dbraun1991/Caddy-Camper-Construction/Einkaufsliste.md

# Einkaufsliste & Budget — VW Caddy Mk3 Camper Ausbau

Preisstand: **Oktober 2026**, Richtpreise aus deutschen Online-Shops (Brutto, inkl. 19 % MwSt., ohne Versand).
Teilenummern beziehen sich auf [List_of_Materials.md](./List_of_Materials.md).

> ⚠ **Vor dem Zuschnitt der Sitz-/Tischbretter C1–C3:** [ADR 0013](docs/adrs/0013-rail-carrier-cheeks-for-seat-and-table-boards.md) ist noch offen (Schienenhöhe 76 mm vs. 32 mm Brettstärke). **Nach Lieferung der Schienen:** Arretierung und Stärke prüfen (Details in [List_of_Materials.md](./List_of_Materials.md) §E). Alles andere ist kaufbereit.

---

## 1 — Holz (Birke-Multiplex)

| Pos | Artikel | Menge | Einzelpreis | Summe |
|---|---|---|---|---|
| — | Multiplex Birke 18 mm, 2.500 × 1.250 mm | 3 Platten | 105 – 147 € | **315 – 441 €** |
| — | Multiplex Birke 12 mm, 2.500 × 1.250 mm | 1 Platte | 50 – 105 € | **50 – 105 €** |
| V16 | Ausgleichsleisten 10 × 40 mm unter dem Klappbrett Rücksitz (F1) | 2 m | ~2,5 €/m ¹ | **~5 €** |
| | | | **Teilsumme** | **~370 – 551 €** |

Spanne erklärt sich über die Qualitätsklasse (BB/BB vs. S/BB) und den Händler: Baumarkt (toom, Hornbach) am unteren Ende, Holzfachhandel (Holzland, Holzzentrum) am oberen.

**Zuschnitt:** 8 – 25 € je nach Händler. Lohnt sich hier klar — die großen Teile (T1, F1, F2, B1 je 1.120 mm breit) sind ohne Formatkreissäge kaum exakt zu schneiden, und ADR 0007 setzt maßhaltige Stirnkanten voraus. **Budget: ~20 €.** Erste Bestellung: 9 Teile in 18 mm, Maße in [List_of_Materials.md §Korpus](./List_of_Materials.md#korpus--unterbau-900-mm-tief-320-mm-hoch-1120-mm-breit) (Wände 340 mm hoch, [ADR 0020](docs/adrs/0020-through-tenons-instead-of-routed-grooves.md)). Passt rechnerisch auf 2 Platten; die 3. Platte und die 12-mm-Platte erst für Schubladen und Sitzbretter.

### Option: CNC-Fräsen statt Zuschnitt

Statt Zuschnitt + Stich-/Kreissäge können die 9 Bretter der ersten Bestellung fertig gefräst werden — mit Zapfen, Schlitzen und Aussparungen. Die Dateien liegen bereit: [`docs/cnc/gezapft/`](docs/cnc/gezapft/) (DXF je Brett + [`AUFTRAG.md`](docs/cnc/gezapft/AUFTRAG.md) zum Mitschicken, im Viewer Reiter „DXF · CNC“, [ADR 0023](docs/adrs/0023-cnc-dxf-export-with-dogbones.md)). **Preis: auf Anfrage**, noch kein Angebot. Fräserdurchmesser (angenommen 6 mm) und Passungsluft (0,2 mm) erst nach Rückmeldung des Anbieters in `modell/parameter.json` → `cnc` festlegen und neu erzeugen.

**Zweiter Auftrag: Schubladenkästen D1–D3** ([`docs/cnc/schubladen/`](docs/cnc/schubladen/), [ADR 0024](docs/adrs/0024-cnc-drawer-boxes-finger-joints-and-lightening-windows.md)): 12 Wände in 18 mm mit Fingerzinken und Fenstern (D1/D2) bzw. Lochraster (D3), 3 Böden in 12 mm mit Zapfen — Material dafür ist die 3. Platte 18 mm und die 12-mm-Platte aus der Tabelle oben. Preis ebenfalls auf Anfrage. Die Schienenstärke (bestimmt die Kastenbreite) ist gemessen: 19 mm wie geplant (2026-11-12). Vor der Bestellung nur noch die Schraublöcher der Schiene gegen das volle Schienenband prüfen. Schrauben V8 und Eckleisten V12 entfallen dadurch, ohne Frontblenden auch die Griffe V6 ([ADR 0027](docs/adrs/0027-no-drawer-front-panels-box-front-with-grip-cut-out.md)).

Anbietersuche (**Recherche 2026-11-07**, nur Webseiten gelesen, niemand angefragt). Ziel: Abholung selbst, Raum Duisburg.

| Anbieter | Ort | Stand laut Webseite | Offen |
|---|---|---|---|
| [Brockmann Holz](https://brockmann-holz.de/timber-processing.html) | Bataverstraße 1, 47809 Krefeld · 02151 5124-0 · info@brockmann-holz.de | CNC-Bearbeitungszentrum (Fräsen von Konturen); Birke-Multiplex BFU 100, 4–50 mm, 1.250 × 2.500 mm | Privatkunden? Abholung? Dateiformat? — **erster Kandidat** |
| [RheinRuhr-Holz](https://rheinruhr-holz.de/) | Zinkstr. 30, 45356 Essen | Privatkunden ja, Abholung kostenlos; Zuschnitt nur für Balken (KVH) | kein CNC-Fräsen genannt — höchstens Material |
| [HRW FabLab](https://fablabs.io/labs/hrwfablab?locale=es) | Bottrop | „CNC milling“ gelistet | ob eine Portalfräse für ganze Platten da ist; selbst fräsen |
| Verzeichnis [wlw.de, Duisburg](https://www.wlw.de/de/suche/cnc-fraesarbeiten-fuer-holz/duisburg) | Duisburg / Moers | Einträge u. a. A-Z Möbelfertigteile Tischlerservice, hasenkamp Service (Moers) | alles ungeprüft |
| [Panelzz](https://www.panelzz.com/de/service/maatwerk/) | Wijlre (NL), Versand | fräst Multiplex nach DXF 1:1, Nesting | keine Birke im Sortiment |
| [Hobeth / Holz-Zentrum Theile](https://hobeth.de/holz-cnc-fraesen-lassen/) | Elsterwerda (Brandenburg), Versand | DXF/STEP, auch privat | weit weg |
| [Plattenzuschnitt24](https://www.plattenzuschnitt24.de/Multiplexplatten-Zuschnitt/Multiplexplatte-Birke/) | online, Versand | Birke-Multiplex „gesägt oder gefräst“ | ob Konturen nach DXF |

Nur Plattenzuschnitt (gerade Schnitte, für Zapfen/Schlitze nicht ausreichend, aber z. B. für die reinen Rechtecke F1/F2 oder die Variante „stumpf“):

| Anbieter | Ort | Stand laut Webseite (2026-11-07) | Offen |
|---|---|---|---|
| [myspiegel.de](https://www.myspiegel.de/multiplex-birke-pb-1193.html) | Holländische Str. 207b, 34127 Kassel · **versendet** | Zuschnitt-Konfigurator für Rechtecke (max. 122 × 247 cm, Mindestfläche 0,3 m²); Lieferung mit eigenen Fahrzeugen, in Deutschland 9,90 €, ca. 5–8 Arbeitstage; Abholung im Werk Kassel möglich. Birke-Multiplex in sechs Stärken von 4 bis 21 mm; Äste ausgebessert und „deutlich zu erkennen“, laut Shop **„zum Möbelbau nicht geeignet“** | ob 18 mm lieferbar ist (Stärken nicht einzeln genannt); kein Fräsen nach DXF genannt |
| [AuProTec](https://auprotec.de/de/zuschnitt/multiplex-platten/c/000484) | online | „Zuschnitt nach Maß“, Birke-Multiplex 6,5–30 mm | Produktseite ließ sich nicht auslesen — Fräsen, Versand und Standort nicht geprüft |

Holz Leineweber in Duisburg hat 2019 geschlossen. Daneben lohnt die direkte Frage bei Tischlereien in Duisburg/Moers — viele haben eine CNC-Nesting-Anlage, ohne es online anzubieten.

---

## 2 — Vollauszug-Schienen (der größte Einzelposten)

| Pos | Artikel | Menge | Einzelpreis/Paar | Summe |
|---|---|---|---|---|
| E1 | Schwerlastschiene AOLISHENG 850 mm · 170 kg · 76 mm hoch · Arretierung — Sitzbretter links/rechts (C1/C2) + Tischbrett Mitte (C3) | 3 Paare | 104,99 € | **~315 €** |
| E2 | Schiene AOLISHENG 850 mm · 80 kg · 53 mm hoch · Arretierung — Schubladen (D1–D3) | 3 Paare | 61,99 € | **~186 €** |
| | | | **Teilsumme** | **~501 €** |

Gut **ein Drittel des Gesamtbudgets**. Beide aus derselben 850-mm-Serie ([ADR 0017](docs/adrs/0017-850-mm-runners-in-900-mm-corpus.md)); Schwerlast überall, wo eine Person sitzen kann — auch auf dem Tischbrett C3 ([ADR 0021](docs/adrs/0021-table-board-on-170-kg-runners.md)). Bestellt sind 2 × E1 + 4 × E2 (2026-11-04): Stand 2026-11-12 laut Bauherr: **3 Paare E1 + 3 Paare E2**, passend bestellt. 170-kg-Schiene: Einbaumaß laut Hersteller 19,2 + 0,5 mm je Seite, passt. Geliefert, gemessen 2026-11-12: beide Typen **19 mm** stark wie geplant, Höhen 53 / 76 mm, Längen 850 / **870 mm** (+ Arretierungshebel vorn), 170-kg-Schiene für **M6**-Schrauben ([ADR 0028](docs/adrs/0028-height-plan-board-on-cheeks-foolproof-runner-layout.md)).

- Bei den Sitz- und Tischbrettern **nicht** sparen: dort sitzt eine Person bei 850 mm Auszug, und ADR 0008 macht die Arretierung zur harten Anforderung.
- Preisvergleich: Nicht-Amazon-Quellen (teleskopschienen-shop.de, teleskopschienen24.de) lagen bei 900 mm/120 kg um ~84 €/Paar — 850 mm dort prüfen.

---

## 3 — Befestigungsmaterial

| Pos | Artikel | Menge | Summe |
|---|---|---|---|
| V1 | Schrauben Torx Senkkopf 4 × 45 mm | ~80 Stk. (1 Pack 100) | ~12 € |
| V2 | Schrauben Torx 3,5 × 16 mm, Flach-/Tellerkopf (80-kg-Schienen) | ~70 Stk. (1 Pack 100) | ~8 € |
| V18 | Schrauben Torx 5 × 16 mm, Flach-/Tellerkopf (170-kg-Schienen, M6-Löcher) | ~60 Stk. (1 Pack 100) | ~10 € ² |
| V3 | Stahlwinkel 40 × 40 × 2 mm | 12 Stk. | ~18 € |
| V4 | Holzdübel Ø 8 × 40 mm | ~30 Stk. (1 Pack 50) | ~6 € |
| V5 | Holzleim D3 wasserfest, 750 ml | 1 Flasche | ~12 € |
| V7 | Schrauben 4 × 30 / 4 × 40 mm | je 1 Pack 100 | ~20 € |
| V9 | M6 × 30 Durchsteckschrauben + U-Scheibe + Stoppmutter | 24 Sätze | ~15 € ² |
| V10 | M8 × 30/40 + U-Scheibe + Stoppmutter | 4 Sätze | ~6 € |
| V11 | Spanngurt mit Ratsche | 2 Stk. | ~20 € |
| V15 | Gurtschlaufe verstellbar (Gurtband ~25 mm + Klemmschnalle), Klappbrett Kopfende (F2) ↔ Kopfstütze | 2 Stk. | ~10 € ¹ |
| V17 | Klappscharniere Standard ~60 mm (3 × Deckplatte ↔ Klappbrett Rücksitz oben, 3 × zwischen den Klappbrettern unten) | 6 Stk. | ~15 € ¹ |
| | | **Teilsumme** | **~154 €** |

¹ V15/V16/V17 am 2026-10-17 ergänzt — grobe Schätzung, Quellen noch nicht geprüft.  
² V9 (M6 statt M5) und V18 am 2026-11-12 nach dem Datenblatt der 170-kg-Schiene geändert bzw. ergänzt ([ADR 0028](docs/adrs/0028-height-plan-board-on-cheeks-foolproof-runner-layout.md)) — grobe Schätzung.

---

## 4 — Ausbau / Sonstiges

| Pos | Artikel | Menge | Summe |
|---|---|---|---|
| G1 | Matratze — **Variante A:** Standard 100 × 200 × 8–13 cm Kaltschaum | 1 | 60 – 150 € |
| G1 | Matratze — **Variante B:** Maßanfertigung 110 × 200 × 8 cm | 1 | 230 – 550 € |
| G2 | Matratzenbezug, atmungsaktiv | 1 | 30 – 60 € |
| G3 | Antirutschmatte / Gummimatte 1.120 × 900 mm | 1 | 15 – 30 € |
| G4 | Kantenband Buche 18 mm selbstklebend | ~8 m | ~10 € |
| G5 | Holzöl / Hartwachsöl | 0,75 l | 20 – 30 € |
| | | **Teilsumme (Variante A)** | **~135 – 280 €** |
| | | **Teilsumme (Variante B)** | **~305 – 680 €** |

**Zur Matratze:** die geplanten **1.100 mm** sind kein Handelsmaß — Standardgrößen sind 900 oder 1.000 mm. Drei Wege:

1. **100 × 200 cm von der Stange** (60 – 150 €) und 100 mm Luft in Kauf nehmen oder mit einem Schaumstreifen füllen. Günstigste Lösung.
2. **Schaumplatte RG40, 2.000 × 1.100 × 80 mm zuschneiden lassen** (~100 – 160 €) und separat beziehen. Bestes Preis-Leistungs-Verhältnis beim geplanten Maß.
3. **Wohnmobil-Matratze nach Maß** (230 – 550 €, Vanmade/Frankenschaum/matratzenachmass). Komfortabel, aber hier der teuerste Posten pro Nutzen.

---

## 5 — Gesamtbudget

| Block | Günstig | Mittel (realistisch) | Komfort |
|---|---|---|---|
| Holz + Zuschnitt | 390 € | 467 € | 571 € |
| Schienen | 501 € | 501 € | 501 € |
| Befestigungsmaterial | 154 € | 154 € | 154 € |
| Ausbau / Sonstiges | 135 € | 230 € | 680 € |
| **Summe** | **~1.180 €** | **~1.350 €** | **~1.905 €** |
| + Puffer 10 % (Verschnitt, Nachkauf, Versand) | ~120 € | ~135 € | ~190 € |
| **Gesamt** | **~1.300 €** | **~1.485 €** | **~2.095 €** |

### Realistische Planungsgröße: **~1.500 €**

Das setzt voraus: Multiplex aus dem Baumarkt mit Zuschnitt, die empfohlenen Schienen, Matratze als zugeschnittene Schaumplatte, Werkzeug schon vorhanden.

**Nicht enthalten:** Werkzeug (Akkuschrauber, Handkreissäge mit Führungsschiene und Stichsäge für die Zapfen, Feilen — oder Dübelhilfe bei stumpfer Variante, Senker), Versandkosten, sowie die noch offenen Punkte Belüftung und 12-V-Installation aus der [README](./README.md#weiterführende-planung).

---

## 6 — Einordnung

Die kommerzielle Alternative [Moonbox 111](https://www.moonbox.de/products/moonbox-111) liegt je nach Ausstattung bei grob 900 – 1.400 € — allerdings ohne Vollauszüge in dieser Tragfähigkeit und ohne drei unabhängige Sektionen. Der Eigenbau rechnet sich hier nicht über den Preis, sondern über die Vollauszug-Funktion und die Passgenauigkeit; die 6 Schwerlastschienen allein kosten mehr als ein Drittel einer Moonbox.

---

## 7 — Kaufreihenfolge

Die Montagereihenfolge in [§H](./List_of_Materials.md#montagereihenfolge) gibt die Kaufreihenfolge vor — der fertige Korpus liefert das verbindliche Innenmaß, nicht die Zeichnung:

1. **Jetzt:** Holz 18 mm + 12 mm mit Zuschnitt (oder die 18-mm-Teile CNC-gefräst, §1), Leim, Dübel, Schrauben V1/V2/V7, Winkel V3, Spanngurte V11 → Korpus bauen
2. **Schienen** E1 (3 Paare) + E2 (3 Paare), Durchsteckschrauben V9 → Arretierung und Stärke prüfen, einmessen und montieren (Bretter C1–C3 erst nach ADR 0013 zuschneiden)
3. **Nach Einbau im Fahrzeug:** M8-Sätze V10 (Gewinde der Zurrösen erst am Auto prüfen; Rücksitz-Ösen liegen neben dem Korpus → Winkel außen an S1/S2, ADR 0016)
4. **Zuletzt:** Matratze G1 + Bezug G2 — erst messen, wenn die Liegefläche real liegt; Scharniere V17, Gurtschlaufen V15 und Ausgleich V16 beim Anpassen von F1/F2 im Fahrzeug
