dbraun1991/Caddy-Camper-Construction/Hinweise-Sommernutzung.md

# Hinweise zur Sommernutzung — Schlafen im Fahrzeug

Dieses Dokument sammelt Punkte rund ums Schlafen im Auto, die **über die Konstruktion
des Ausbaus hinausgehen** — Themen, die unabhängig vom konkreten Innenausbau gelten,
aber jeder Nutzung eines Fahrzeugs als Schlafplatz anhaften.

**Rahmenbedingungen dieser Einschätzung** (bewusst explizit gemacht, weil sie entscheiden,
was hier wichtig ist und was nicht):

- **Nur Sommer-/Übergangszeit.** Deshalb werden Standheizung und **Kondensat**
  (Feuchtigkeit schlägt sich an kalten Scheiben/Wänden nieder, Schimmelrisiko über Wochen)
  hier **bewusst nicht behandelt** — das sind primär Kälte-/Dauerbetrieb-Probleme. Bei
  Nutzung außerhalb des Sommers (Übergangszeit, erste/letzte Törns) sollte das nachgezogen
  werden. **Davon zu unterscheiden** ist der CO₂-/Frischluftbedarf durch die Atmung selbst
  (→ Abschnitt 3) — der ist nicht saisonabhängig und bleibt deshalb vollständig in Scope,
  auch im Sommer.
- **Der Caddy ist aktuell ein normales Serienfahrzeug.** Keine Scheibentönung, keine
  Vorhänge, keine Dachluke, keine Mückengitter, keine Standheizung, keine Umbauten an
  Sitzen/Gurten/Kopfstützen außer dem hier geplanten Ausbau. Alles unten ist also etwas,
  das fehlt, nicht etwas, das schon vorhanden ist und nur geprüft werden muss.

---

## 1 — Rechtliches: Rasten ist erlaubt, Campen oft nicht

In Deutschland ist das Schlafen im Fahrzeug zur eigenen Erholung (Sekundenschlaf-Vermeidung,
Fahrtunterbrechung) grundsätzlich erlaubt und sogar erwünscht — auch auf Autobahnrastplätzen,
zeitlich im Rahmen einer "angemessenen Ruhezeit" (häufig genannte Richtgröße: bis zu einer
Nacht). **Camping** — Tisch und Stühle vor dem Fahrzeug aufstellen, Markise ausfahren,
sich sichtbar häuslich einrichten — ist dagegen auf Rastplätzen, in vielen Innenstädten und
in Naturschutzgebieten verboten und wird von Gerichten und Kommunen unterschiedlich streng
ausgelegt. Die Grenze zwischen beidem ist nicht gesetzlich scharf definiert, sondern
Einzelfallrechtsprechung — "wirkt es wie ein Zeltplatz" ist das informelle Kriterium.

⚠ **Das betrifft diesen Ausbau konkret:** Der **Bankmodus** fährt Sitz- und Tischbrett
850 mm nach hinten aus der offenen Heckklappe heraus — das ist im Erscheinungsbild genau
die Camping-Geste (Tisch + Sitzgelegenheit außerhalb des Fahrzeugs), die diese Abgrenzung
adressiert, auch wenn technisch alles am Fahrzeug montiert bleibt.

**Praktische Konsequenz:**

| Modus | Rechtlich unauffällig | Nur an erlaubten Stellplätzen |
|---|---|---|
| Schlafmodus | ✅ überall, wo Parken/Rasten erlaubt ist | — |
| Packmodus (Schubladen raus, kein Sitzmöbel sichtbar) | ✅ meist unkritisch | — |
| **Bankmodus** (Tisch/Sitzbrett sichtbar ausgefahren) | ⚠ nein | Nur auf ausgewiesenen Reisemobil-Stellplätzen oder mit Erlaubnis |

→ Bankmodus als "das ist jetzt ein Zeltplatz"-Signal einplanen, nicht als generell nutzbare
Funktion. Auf Autohof/Rastplatz lieber im Schlafmodus bleiben und nur innen sitzen.

---

## 2 — Zulassung / StVZO: Serienfahrzeug bleibt verkehrssicher

Der Ausbau darf die Zulassung des Fahrzeugs als PKW/Kombi nicht gefährden. Drei konkrete
Punkte, die über die reine Konstruktion hinausgehen:

- **Sichtfeld:** Sichtschutz/Verdunkelung (→ Abschnitt 4) darf **nur im Stand** angebracht
  sein, nie während der Fahrt — auch nicht an Seiten- oder Heckscheiben, falls diese für
  Schulterblick/Rückspiegel relevant sind.
- **Fahren mit geklappter Liegefläche (Fahrmodus 1/2):** Die auf die Box geklappten
  Klappbretter (F1, F2) hängen nur an den Scharnieren — vor der Fahrt mit einem Spanngurt am Korpus sichern,
  Matratze gesichert verstauen. Lose Platten dieser Größe werden bei einer Vollbremsung zu
  Geschossen.
- **Kopfstützenfunktion beim Klappbrett Kopfende (F2):** Das Klappbrett Kopfende wird laut `List_of_Materials.md` §H4 mit
  zwei verstellbaren Gurtschlaufen an den Vordersitz-Kopfstützen fixiert; die Zuglast tragen
  die Kopfstützen. Die Kopfstützen müssen dafür in Normalposition
  bleiben und ihre HWS-Schutzfunktion (Kopfstütze fängt den Kopf bei Auffahrunfall) behalten
  — die Befestigung darf sie nicht nach vorne ziehen, blockieren oder in der Höhe
  verstellen. Vor der ersten Fahrt mit montiertem F2 die Kopfstützen auf normale Beweglichkeit
  prüfen.
- **Zuladung (Zuladung/Nutzlast) — noch nicht geprüft:** Der gesamte Ausbau wiegt grob
  geschätzt:

  | Posten | Gewicht |
  |---|---|
  | Multiplex 18 mm (~7,5 m² × 18 mm × ~700 kg/m³) | ~95 kg |
  | Multiplex 12 mm (~1,5 m² × 12 mm × ~700 kg/m³) | ~13 kg |
  | 6 Schienenpaare (12 Stk.) | ~12 kg |
  | Kleineisen (Schrauben, Winkel, Dübel, Leim) | ~5 kg |
  | Matratze | ~10 kg |
  | **Ausbau gesamt (Leergewicht)** | **~135 kg** |

  Dazu kommen Insassen (2 Personen ≈ 150 kg) und Gepäck/Campingausrüstung (~30–50 kg) —
  grob **315–335 kg zusätzlich zum Serienzustand**. Die Nutzlast eines Caddy Mk3 Kombi
  schwankt stark nach Motorisierung/Ausstattung (Erfahrungswerte reichen von ~425 kg bis
  ~770 kg). **Vor dem Bau im Zulassungsschein/Zulassungsbescheinigung Teil I prüfen:**
  Feld F.1 (zul. Gesamtmasse) minus Leergewicht = tatsächliche Nutzlast dieses konkreten
  Fahrzeugs. Bei einer knapp bemessenen Nutzlast ist der 18-mm-Multiplex-Anteil der größte
  Hebel, falls Gewicht gespart werden muss.

- **Ladungssicherung während der Fahrt:** bereits entschieden, siehe
  [ADR 0012](docs/adrs/0012-non-destructive-vehicle-tie-down.md).

---

## 3 — Lüftung: Hitze und CO₂ sind die Probleme, nicht Feuchtigkeit

Zwei getrennte, beide saisonunabhängige Gründe, warum ein komplett geschlossenes Fahrzeug
über Nacht keine gute Idee ist — Kondensat (Abschnitt-übergreifend bewusst ausgeklammert,
siehe oben) ist keiner davon:

**a) CO₂-Anstieg durch Atmung.** Zwei schlafende Erwachsene atmen zusammen grob 25–30 l
CO₂ pro Stunde aus. Bei einer Kabinenluftmenge von überschlägig ~3 m³ (3.000 l) und
**keinem** Luftaustausch wäre die CO₂-Konzentration nach 8 Stunden rein rechnerisch im
Bereich mehrerer Zehntausend ppm — weit über der Schwelle (ca. 2.000–5.000 ppm), ab der
Kopfschmerzen, Benommenheit und schlechter, unruhiger Schlaf auftreten. In der Praxis ist
kein Fahrzeug hundertprozentig luftdicht (Türdichtungen, Kabeldurchführungen, Ablauflöcher
lassen immer etwas durch), ein echtes Erstickungsrisiko bei diesem Luftvolumen ist deshalb
unwahrscheinlich — aber sich auf die Restundichtigkeit zu verlassen ist kein Sicherheitskonzept,
und "schlecht geschlafen, Kopfschmerzen am Morgen" ist ein beim Autoschlafen häufig
berichtetes, vermeidbares Problem.

**b) Hitzestau.** Ein geschlossenes Fahrzeug in der Sommersonne heizt sich tagsüber stark
auf; nachts kühlt es ohne Luftaustausch langsamer ab.

Beide Probleme teilen dieselbe Lösung — Fenster angekippt lassen — aber aus zwei
unabhängigen Gründen, nicht nur wegen der Hitze:

- **Zwei gegenüberliegende Fenster ankippen, nicht nur eines** — Querlüftung sorgt auch
  ohne Wind für echten Luftaustausch statt stehender Luft in einer Ecke.
- Dafür braucht es **Einbruchschutz am offenen Spalt** (siehe Abschnitt 6) und einen
  **Insektenschutz** (Abschnitt 5), sonst ist die Lüftung nachts nicht praktikabel.
- Tagsüber beim Parken in der Sonne: Frontscheiben-Sonnenschutz von außen reduziert den
  Hitzestau deutlich mehr als jede Lüftungsmaßnahme im Innenraum.
- Die bereits geplante offene Vorderseite des Korpus (`README.md` "Render-Architektur")
  und der nicht abgedichtete Laderaum helfen hier zufällig mit — es gibt ohnehin keinen
  luftdichten Kasten, der zusätzlich belüftet werden müsste.
- **Objektive Kontrolle statt Bauchgefühl:** ein einfaches batteriebetriebenes CO₂-Messgerät
  (ab ~30–50 €) zeigt, ob der gewählte Fensterspalt tatsächlich reicht — deutlich
  verlässlicher, als am Morgen an Kopfschmerzen zu merken, dass er es nicht tat.

---

## 4 — Sichtschutz & Sonnenschutz

Serienfahrzeug ohne Tönung heißt: von außen ist nachts alles einsehbar, tagsüber heizt sich
der Innenraum ungebremst auf. Zwei Funktionen, ein Produkt:

- **Thermo-/Verdunkelungsmatten** (zugeschnitten auf die Scheibenformen, z. B. Saugnapf-
  oder Klemmbefestigung) für Front-, Seiten- und Heckscheiben — wirken gegen Einblick von
  außen **und** gegen Aufheizen tagsüber.
- Nur im Stand anbringen (siehe Abschnitt 2, Sichtfeld).
- Kostengünstige Variante: reflektierende Isoliermatten (Pkw-Zuschnitt, pro Scheibe
  einzeln) statt eines kompletten Sets — für einen Serienwagen ohne Sonderzuschnitt meist
  ausreichend.

---

## 5 — Insektenschutz

Ohne Mückengitter ist "Fenster nachts offen" (Abschnitt 3) im Sommer kaum nutzbar.

- Magnet- oder Klett-Mückennetze für die vorderen Fenster (passend zum Fensterrahmen,
  Caddy-spezifisch oder Universal-Zuschnitt).
- Mückennetz für die Heckklappe, falls diese im Bankmodus zum Lüften/Sitzen offen bleibt —
  wird ebenfalls erst bei Umsetzung des Ausbaus relevant, da die Heckklappe dann häufiger
  offen steht als im Serienbetrieb.

---

## 6 — Einbruch-/Diebstahlschutz

Ein gekipptes Fenster zum Lüften (Abschnitt 3) ist ein Zielpunkt. Faustregeln:

- Fenster nur so weit öffnen, wie ein Arm nicht durchpasst, oder ein Fenstergitter/-spanner
  verwenden, der den Spalt zusätzlich sichert.
- Zentralverriegelung aktiv halten (bei VAG-Fahrzeugen über die Fernbedienung auch von
  außen fernsteuerbar — Komfortfunktion vorher prüfen, ob sie bei nur angelehnten Fenstern
  trotzdem korrekt verriegelt).
- Wertsachen grundsätzlich nicht sichtbar liegen lassen — bei einem erkennbaren
  Campingausbau (Schubladen, Brettkante sichtbar) ist das Fahrzeug als "da ist wahrscheinlich
  Ausrüstung drin" erkennbar, was es als Ziel eher interessanter macht als ein leerer
  Serien-Caddy.

---

## 7 — Stellplatzwahl

- Eben und ruhig — auf 320 mm Plattformhöhe ohne Niveauausgleich schläft es sich auf einer
  Steigung unangenehm, und die Schienen-Arretierungen (ADR 0008) sind für Lastaufnahme
  ausgelegt, nicht als Bremse gegen Wegrollen von Schubladen bei starker Seitenneigung.
- Nur an Stellen parken, an denen Übernachten erlaubt ist (siehe Abschnitt 1) — offizielle
  Stellplätze, Wanderparkplätze ohne Verbotsschild, oder mit Zustimmung (z. B. Hofplatz).
- Eher belebte/beleuchtete Orte statt komplett abgelegen — Sichtschutz (Abschnitt 4) macht
  den Einblick zwar schwerer, ersetzt aber keine sichere Umgebung.

---

## 8 — Brandschutz / CO (falls ein Kocher mitgeführt wird)

Noch nicht Teil der Materialliste, aber ein häufiger Begleiter bei dieser Art Ausbau — daher
als Warnhinweis hier, falls ein Gas- oder Benzinkocher angeschafft wird:

- **Nie im Innenraum kochen** — Kohlenmonoxid-Vergiftung ist lautlos und bei geschlossenem
  Fahrzeug im Schlaf tödlich. Kocher ausschließlich draußen bei offener Tür/Heckklappe mit
  Blick auf den Kocher verwenden, nie "schnell drin" bei Regen.
- Falls doch ein Kocher fest verbaut werden sollte (aktuell nicht geplant): das wäre ein
  eigener Punkt mit CO-Warnmelder und Gasflaschenkasten mit Bodenentlüftung, kein
  nachträglicher Zusatz.

---

## Zusammenfassung: was zu besorgen/prüfen ist

| # | Punkt | Typ |
|---|---|---|
| 1 | Zuladung im Zulassungsschein prüfen (Feld F.1 − Leergewicht) | Prüfung, keine Anschaffung |
| 2 | Kopfstützenfunktion mit montiertem F2 testen | Prüfung |
| 3 | Thermo-/Verdunkelungsmatten für Front-, Seiten-, Heckscheiben | Anschaffung |
| 4 | Mückennetze für vordere Fenster + Heckklappe | Anschaffung |
| 5 | Fenstersicherung für den gekippten Lüftungsspalt | Anschaffung |
| 6 | Bankmodus nur an erlaubten Stellplätzen nutzen | Verhaltensregel, keine Anschaffung |
| 7 | Immer 2 gegenüberliegende Fenster ankippen (CO₂ + Hitze, → Abschnitt 3) | Verhaltensregel, keine Anschaffung |
| 8 | Optional: CO₂-Messgerät zur Kontrolle des Fensterspalts | Anschaffung (optional) |

Diese Posten sind **nicht** in [Einkaufsliste.md](./Einkaufsliste.md) eingerechnet, da sie
nicht zum Korpus-/Ausbau-Budget gehören. Geschätzte Zusatzkosten für Punkte 3–5 und 8: grob
90–170 €.
