dbraun1991/Caddy-Camper-Construction/docs/adrs/0017-850-mm-runners-in-900-mm-corpus.md

# 0017: 850 mm runners in the 900 mm corpus

Status: Accepted — amends [ADR 0008](0008-heavy-duty-full-extension-runners.md) (runner length only); amended by [ADR 0021](0021-table-board-on-170-kg-runners.md) (`C3` moves to the 170 kg runner) — **amended by [ADR 0028](0028-height-plan-board-on-cheeks-foolproof-runner-layout.md)**: the delivered 170 kg runners measure 870 mm
(+ 30 mm lock lever in front), the 80 kg runners 850 mm; both still fit the 882 mm clear depth.

## Context

ADR 0008 chose 900 mm runners because the corpus is 900 mm deep. The overlap
check from ADR 0015 showed that this never fitted: the back wall `R1` (18 mm)
leaves **882 mm** of clear depth, so 900 mm runners, the 880 mm drawer boxes
behind their 18 mm fronts, and the 900 mm seat/table boards all ran 14–18 mm
into the back wall (18 overlaps).

The 900 mm corpus depth itself has a real reason: the lid `T1` is part of the
sleeping platform and must reach the folded rear seats where `F1` starts. The
measured load depth is 920–930 mm (2026-10-17). The builder wants to keep the
corpus at 900 mm and keep ~2 cm of air at the rear-seat end, not use the space
for a deeper corpus.

Options:

- **Corpus 918 mm** (back wall behind 900 mm clear depth) — keeps 900 mm runners,
  but only 2–12 mm left to the rear seats.
- **Thinner back wall** (12 mm) — 888 mm clear, still too short, and weakens the
  main anti-racking panel (ADR 0007).
- **850 mm runners in the unchanged corpus** — chosen.

## Decision

- Corpus stays **900 mm** deep; 20–30 mm air to the rear seats.
- Two runners from the same AOLISHENG 850 mm full-extension series, both with
  lock (prices seen 2026-10-17):
  - **Seat boards `C1`/`C2`** (a person sits on them): 170 kg, 76 mm high,
    104.99 € per pair — 2 pairs.
  - **Drawers `D1`–`D3` and table board `C3`**: 80 kg, 53 mm high, 61.99 € per
    pair — 4 pairs. Luggage and a table, not a seat.
  - The 95 kg / 53 mm board runner from ADR 0008 is dropped (only found in
    900 mm).
- The assignment lives in `modell/parameter.json` (`schienen.typen`,
  `schienen.zuordnung`); rail bands are derived per type (seat L/R 18–94,
  drawer L/R ≈ 202–255, drawer M ≈ 78–131, table M 262–315 mm — no overlap on
  the dividers).
- Derived in `modell/parameter.json`: drawer box depth **830 mm** (runner − 20,
  as before), seat/table board depth **850 mm** (= runner length).
- Behind the runners and elements: **32 mm** clear space before `R1`.

## Consequences

- The 18 back-wall overlaps are gone; what remains are the open corner
  construction and the drawer-front/runner conflict.
- Extension in Bankmodus/Packmodus is 850 mm instead of 900 mm. The tipping
  estimate in ADR 0016 (based on 900 mm) stays as a slightly conservative figure.
- **To verify before ordering:** the runner thickness per side. The listing
  gives the 76 mm height but not the thickness; every element width is computed
  with 19 mm (ADR 0006/0008), for both types. A different thickness changes the
  affected element widths and must go into `schienen.typen.<typ>.staerke`.
- The lock requirement of ADR 0008 is unchanged. ADR 0008's note that the 95 kg
  board runners are the limit of the seating arrangement no longer applies —
  the seat boards now run on 170 kg runners. The table board's 80 kg runner is
  not meant to be sat on.
- The seat boards now face a **76 mm** runner instead of 53 mm (the table board
  stays at 53 mm), which changes the numbers in the still-open ADR 0013.
