dbraun1991/Caddy-Camper-Construction/docs/adrs/0018-continuous-bottom-and-lid-walls-in-grooves.md

# 0018: Continuous bottom and lid; walls housed in grooves between them

Status: Accepted, grooves replaced by through tenons in [ADR 0020](0020-through-tenons-instead-of-routed-grooves.md); continuous `B1`/`T1` still applies. Amends [ADR 0007](0007-dowel-screw-bracket-joinery.md).

## Context

The cut list gave the walls `S1/S2`/`M1/M2` 320 mm height *and* the bottom `B1` and back
wall `R1` the full 1,120 mm width. That only works if somebody decides which
panel runs through at each corner; the overlap check (ADR 0015) showed them
colliding at every corner. The workshop drawings offered three variants.

The builder's decision (2026-10-17): **bottom plate `B1` and lid `T1` run through
at the full 1,120 × 900 mm**; all walls stand between them. On top of that the
builder intends to rout recesses into `B1` and `T1` so the walls plug in —
which turns the overlap into an intended housing joint.

## Decision

- `B1` and `T1`: 1,120 × 900 × 18 mm, uninterrupted. All walls stand between them.
- Walls are housed in `B1` and `T1`, **6–9 mm deep depending on the tool**
  (model and drawings use the nominal 6 mm), as a **rebate (Falz)** along the open-to-the-outside edges
  (`S1/S2` left/right, `R1` back) and as a **groove (Nut)** for the dividers `M1/M2`.
  Wall height = **302 + 2 × depth** (314 mm at 6 mm); clear interior height
  stays 302 mm. The walls are cut **after** routing, to the measured depth.
- Not deeper than about half the board (~9 mm), and never sawn through: the
  recesses run the full 900 mm, so a through-rebate would remove the edge of
  `B1`/`T1` (contradicting "continuous") and a through-groove would split the
  board. The builder's first idea (6–20 mm, "ausgespart oder durchgesägt")
  was narrowed to this for that reason.
- `R1` sits between the side walls (1,084 mm), `M1/M2` runs up to `R1` (882 mm).
- Parameters: `korpus.nut_tiefe` and `eckausbildung` (`genutet` | `stumpf`) in
  `modell/parameter.json`. `stumpf` (walls 302 mm, no recess) is kept as the
  fallback if routing turns out impractical — the cut sizes of `B1`/`T1` are the
  same in both.

Cut sizes (`genutet`, at the nominal 6 mm):

| Part | Size |
|---|---|
| `B1`, `T1` | 1,120 × 900 |
| `S1`, `S2` | 900 × 314 |
| `R1` | 1,084 × 314 |
| `M1`, `M2` | 882 × 314 |

## Consequences

- No unresolved corner overlaps remain. The model marks the ten wall-in-recess
  overlaps as intended (green in the drawings) and keeps them out of the
  problem count.
- Joinery (amends ADR 0007): the recess takes over what the dowels did —
  alignment and shear — and the walls no longer stand on bare end grain. Screws
  from above through `T1` and from below through `B1` into the wall edges stay
  for tension; the corner brackets become optional reserve. Dowels (`V4`) are
  only needed for the `stumpf` fallback.
- The old instruction to screw the dividers "from outside through the side
  walls" was geometrically impossible (`M1/M2` is parallel to `S1/S2` and does not
  touch it). Dividers are now fixed by their grooves plus screws through `B1`,
  `T1` and `R1`.
- `B1` and `T1` can be cut now; the walls after routing (302 + 2 × depth).
- Tooling: router with an 18 mm straight bit (or table saw in several passes).
  Birch multiplex is often slightly over nominal thickness — rout a test groove
  in an offcut and fit it to the actual board before cutting the real panels.
  Most cutting services do not rout grooves.
