dbraun1991/Caddy-Camper-Construction/docs/adrs/0019-hinged-sleeping-boards-fold-onto-the-corpus.md

# 0019: Hinged sleeping boards fold back onto the corpus for driving

Status: Accepted — amends [ADR 0004](0004-static-scene-graph-with-z-position-toggle.md) (viewer modes)

## Context

The sleeping boards `F1` (700 mm, on the folded rear seat backs) and `F2`
(400 mm, towards the front headrests) were loose and joined to their
neighbours only by overlap battens (§H4). To drive with the rear seats in use,
both boards have to go somewhere. The builder wants them hinged to the corpus so
they fold back onto the box, using standard surface-mounted hinges.

## Decision

- **`T1`↔`F1`: hinges on top**, **`F1`↔`F2`: hinges underneath** — 3 standard
  folding hinges per joint (`modell/parameter.json` → `scharniere`).
- A surface-mounted hinge only opens towards the side its knuckle is on. On top
  of `T1`↔`F1`, `F1` can only swing up and over onto the box, never sag below
  the platform. Underneath `F1`↔`F2`, `F2` can only fold down while flat; once
  `F1` lies upside down on the box, "down" faces up and `F2` folds onto `F1`.
  Result: a stack `T1` / `F1` / `F2` on the box.
- The pivot axis sits ~3 mm above/below the board face, so the folded boards lie
  ~6 mm apart (the hinge leaves sit in between). Folded positions, computed and
  checked in the viewer: `F1` y 344–362, z 200–900; `F2` y 368–386, z 200–600
  — fully on the corpus; stack height 386 mm.
- The overlap battens `V13` between `T1`/`F1`/`F2` are dropped: the hinges
  locate the joints, and a batten under `F1`'s edge resting on `T1` would also
  block the fold.
- Viewer: two new modes. **Fahrmodus 1** folds both boards onto the box and
  hides the mattress (stowed). **Fahrmodus 2** additionally shows the rear seats
  upright (5 seats). The fold axes come from `modell.py` (`klappachsen`);
  `F1`/`F2` sit in pivot groups that are rotated by 180°.

## Consequences

- ADR 0004 said modes only move parts along Z. The fold modes also **rotate two
  pivot groups**; all geometry still lives permanently in the scene graph and
  nothing is created or removed per mode.
- **Load securing while driving:** the folded stack is held only by the three
  hinges at z = 900. Strap it down to the corpus (e.g. one of the ratchet
  straps `V11`) and stow the mattress securely — loose boards of this size are
  projectiles under hard braking.
- The upright rear seat geometry in the viewer is a placeholder; only the
  position of the seat back (at the measured 920 mm load depth) is grounded.
- The headrest loops of `F2` (§H4) are released before folding.
