dbraun1991/Caddy-Camper-Construction/docs/cnc/gezapft/alle-teile.dxf

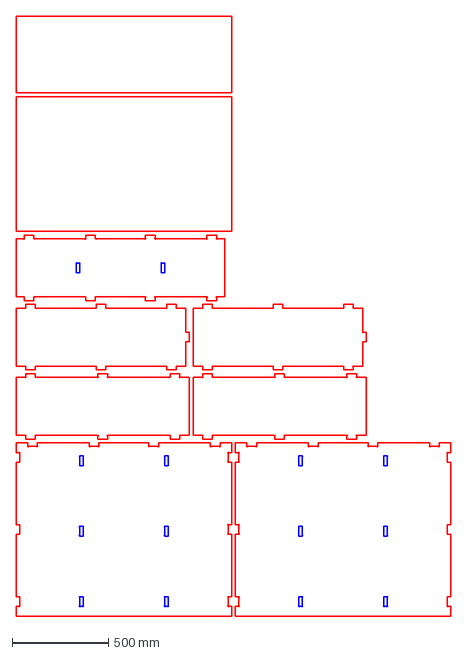
[picture p4: CAD file, 2026-11-07]
docs/cnc/gezapft/alle-teile.dxf
2260.0 x 3120.0 mm
