dbraun1991/Caddy-Camper-Construction/docs/cnc/schubladen/d1-e2-d2-e2.dxf

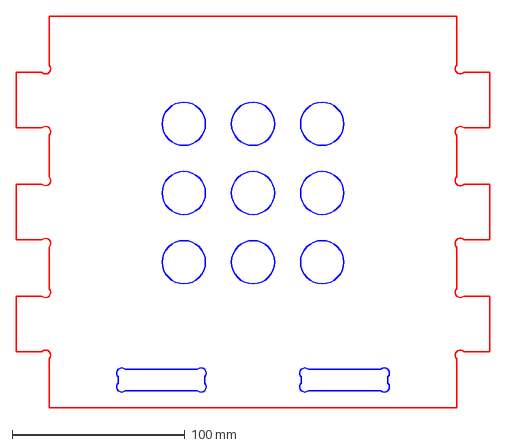
[picture p5: CAD file, 2026-11-12]
docs/cnc/schubladen/d1-e2-d2-e2.dxf
274.0 x 226.5 mm
