dbraun1991/Caddy-Camper-Construction/docs/cnc/stumpf/m1-m2.dxf

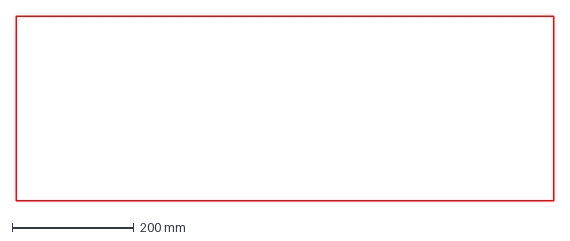
[picture p6: CAD file, 2026-11-07]
docs/cnc/stumpf/m1-m2.dxf
882.0 x 302.0 mm
