dbraun1991/Caddy-Camper-Construction/docs/cnc/schubladen/d1-s-d2-s.dxf

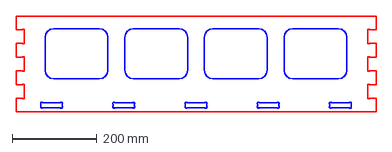
[picture p8: CAD file, 2026-11-12]
docs/cnc/schubladen/d1-s-d2-s.dxf
850.0 x 226.5 mm
