dbraun1991/Caddy-Camper-Construction/docs/cnc/stumpf/f1.dxf

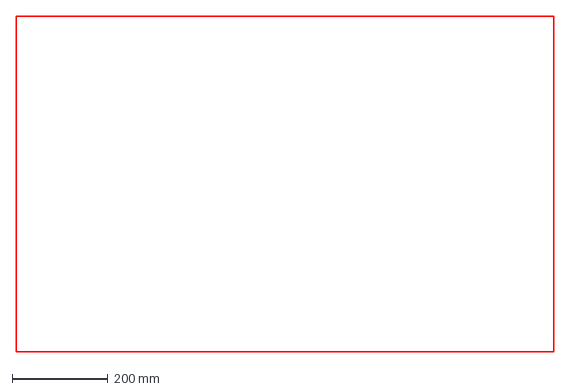
[picture p9: CAD file, 2026-11-07]
docs/cnc/stumpf/f1.dxf
1120.0 x 700.0 mm
