dbraun1991/Caddy-Camper-Construction/docs/cnc/gezapft/f2.dxf

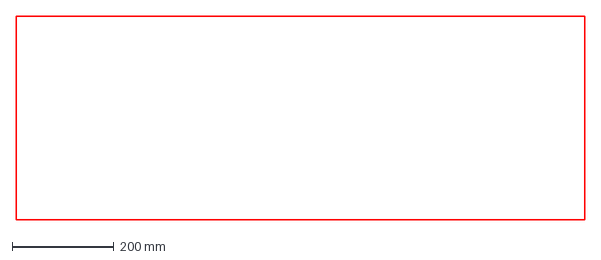
[picture p10: CAD file, 2026-11-07]
docs/cnc/gezapft/f2.dxf
1120.0 x 400.0 mm
