dbraun1991/Caddy-Camper-Construction/docs/cnc/schubladen/d3-e2.dxf

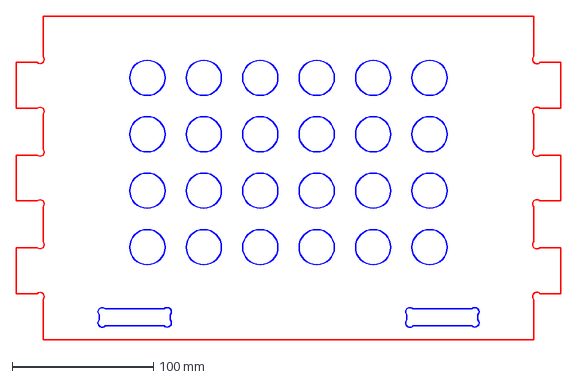
[picture p11: CAD file, 2026-11-12]
docs/cnc/schubladen/d3-e2.dxf
386.0 x 229.5 mm
