dbraun1991/Caddy-Camper-Construction/docs/cnc/stumpf/s1-s2.dxf

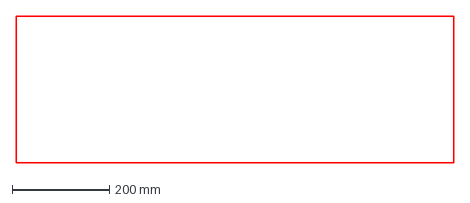
[picture p12: CAD file, 2026-11-07]
docs/cnc/stumpf/s1-s2.dxf
900.0 x 302.0 mm
