dbraun1991/Caddy-Camper-Construction/docs/cnc/gezapft/b1-t1.dxf

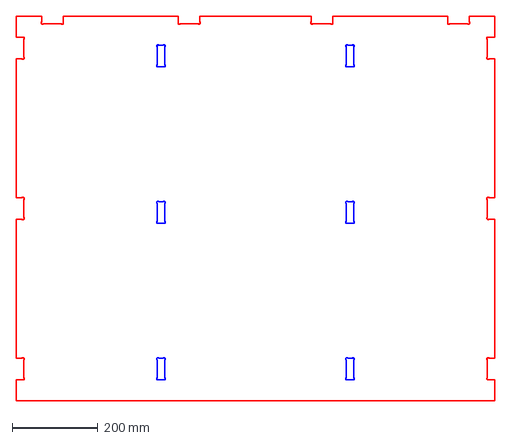
[picture p13: CAD file, 2026-11-07]
docs/cnc/gezapft/b1-t1.dxf
1120.0 x 900.0 mm
