dbraun1991/Caddy-Camper-Construction/docs/cnc/schubladen/d3-s.dxf

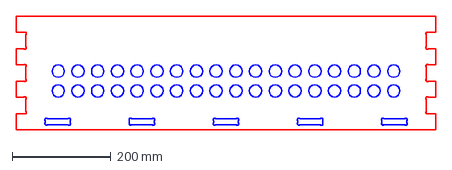
[picture p14: CAD file, 2026-11-12]
docs/cnc/schubladen/d3-s.dxf
850.0 x 229.5 mm
