dbraun1991/Caddy-Camper-Construction/docs/cnc/stumpf/r1.dxf

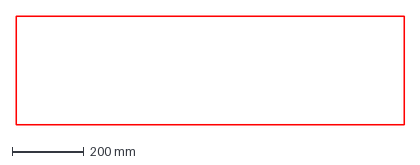
[picture p15: CAD file, 2026-11-07]
docs/cnc/stumpf/r1.dxf
1084.0 x 302.0 mm
