dbraun1991/Caddy-Camper-Construction/docs/cnc/gezapft/m1-m2.dxf

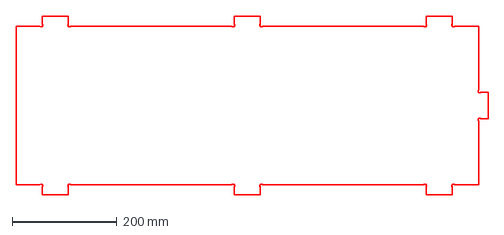
[picture p16: CAD file, 2026-11-07]
docs/cnc/gezapft/m1-m2.dxf
900.0 x 340.0 mm
