dbraun1991/Caddy-Camper-Construction/docs/cnc/schubladen/alle-teile.dxf

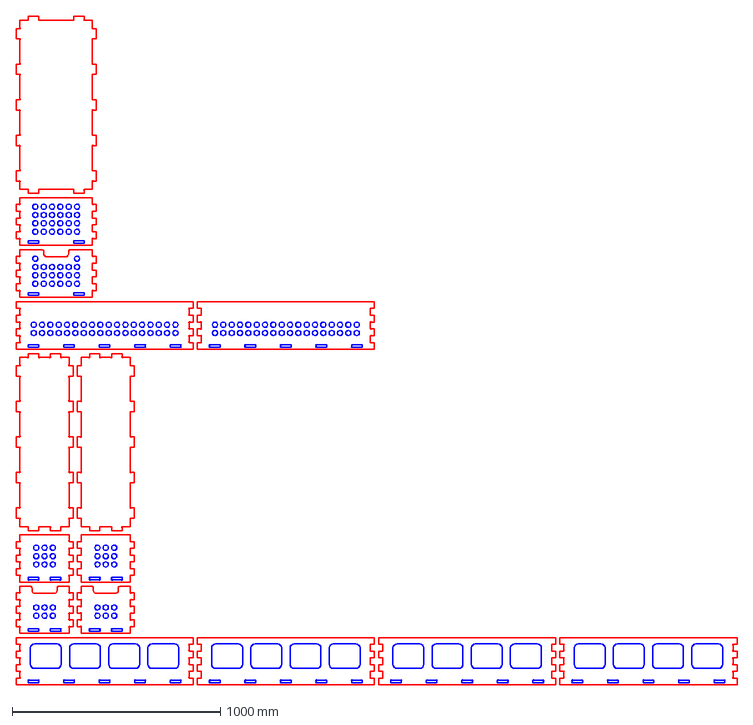
[picture p17: CAD file, 2026-11-12]
docs/cnc/schubladen/alle-teile.dxf
3460.0 x 3208.0 mm
