dbraun1991/Caddy-Camper-Construction/docs/cnc/stumpf/b1-t1.dxf

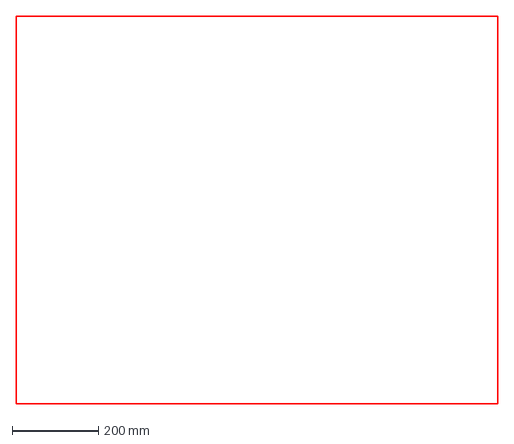
[picture p18: CAD file, 2026-11-07]
docs/cnc/stumpf/b1-t1.dxf
1120.0 x 900.0 mm
