dbraun1991/Caddy-Camper-Construction/docs/cnc/gezapft/r1.dxf

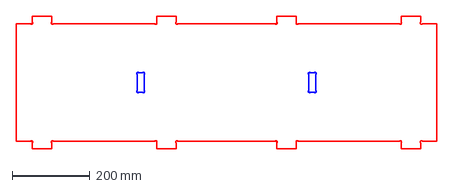
[picture p19: CAD file, 2026-11-07]
docs/cnc/gezapft/r1.dxf
1084.0 x 340.0 mm
