dbraun1991/Caddy-Camper-Construction/docs/cnc/schubladen/d1-e1-d2-e1.dxf

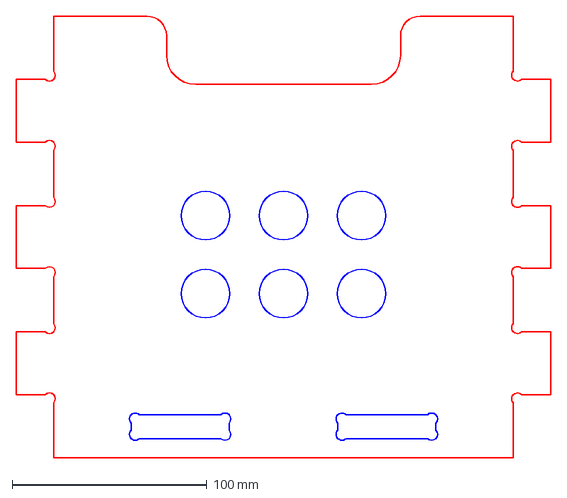
[picture p20: CAD file, 2026-11-12]
docs/cnc/schubladen/d1-e1-d2-e1.dxf
274.0 x 226.5 mm
