dbraun1991/Caddy-Camper-Construction/docs/cnc/stumpf/f2.dxf

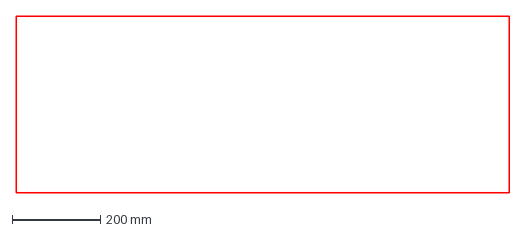
[picture p21: CAD file, 2026-11-07]
docs/cnc/stumpf/f2.dxf
1120.0 x 400.0 mm
