dbraun1991/Caddy-Camper-Construction/docs/cnc/gezapft/s1-s2.dxf

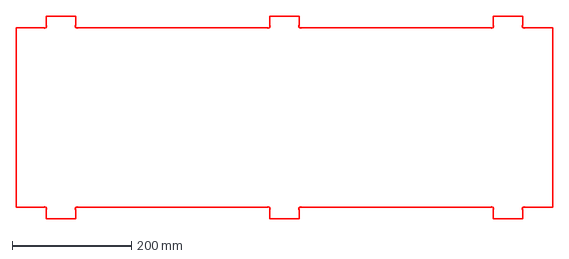
[picture p22: CAD file, 2026-11-07]
docs/cnc/gezapft/s1-s2.dxf
900.0 x 340.0 mm
