dbraun1991/Caddy-Camper-Construction/docs/cnc/stumpf/alle-teile.dxf

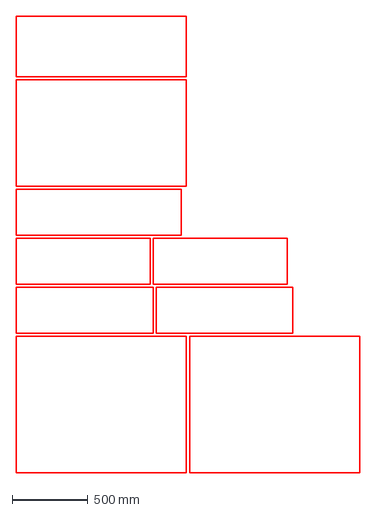
[picture p24: CAD file, 2026-11-07]
docs/cnc/stumpf/alle-teile.dxf
2260.0 x 3006.0 mm
