dbraun1991/Caddy-Camper-Construction/docs/cnc/schubladen/d3-b.dxf

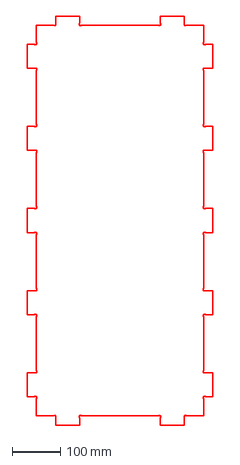
[picture p25: CAD file, 2026-11-12]
docs/cnc/schubladen/d3-b.dxf
386.0 x 850.0 mm
