dbraun1991/Caddy-Camper-Construction/docs/cnc/schubladen/d1-b-d2-b.dxf

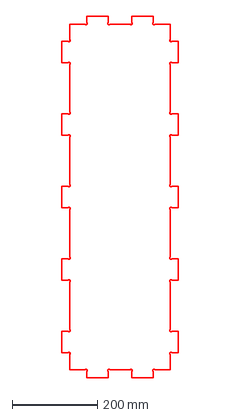
[picture p26: CAD file, 2026-11-12]
docs/cnc/schubladen/d1-b-d2-b.dxf
274.0 x 850.0 mm
