dbraun1991/Caddy-Camper-Construction/docs/cnc/schubladen/d3-e.dxf

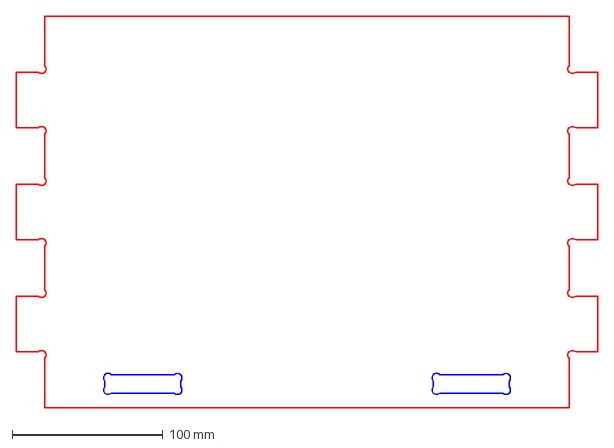
[picture p27: CAD file, 2026-11-12]
docs/cnc/schubladen/d3-e.dxf
386.0 x 260.0 mm
