dbraun1991/Caddy-Camper-Construction/docs/cnc/schubladen/d1-e-d2-e.dxf

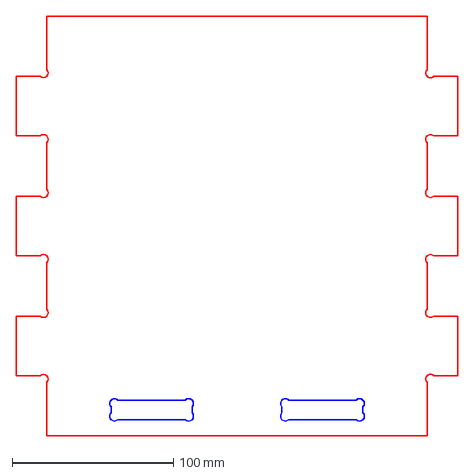
[picture p28: CAD file, 2026-11-12]
docs/cnc/schubladen/d1-e-d2-e.dxf
274.0 x 260.0 mm
