dbraun1991/Caddy-Camper-Construction/docs/zeichnungen/stumpf/werkzeichnungen.pdf

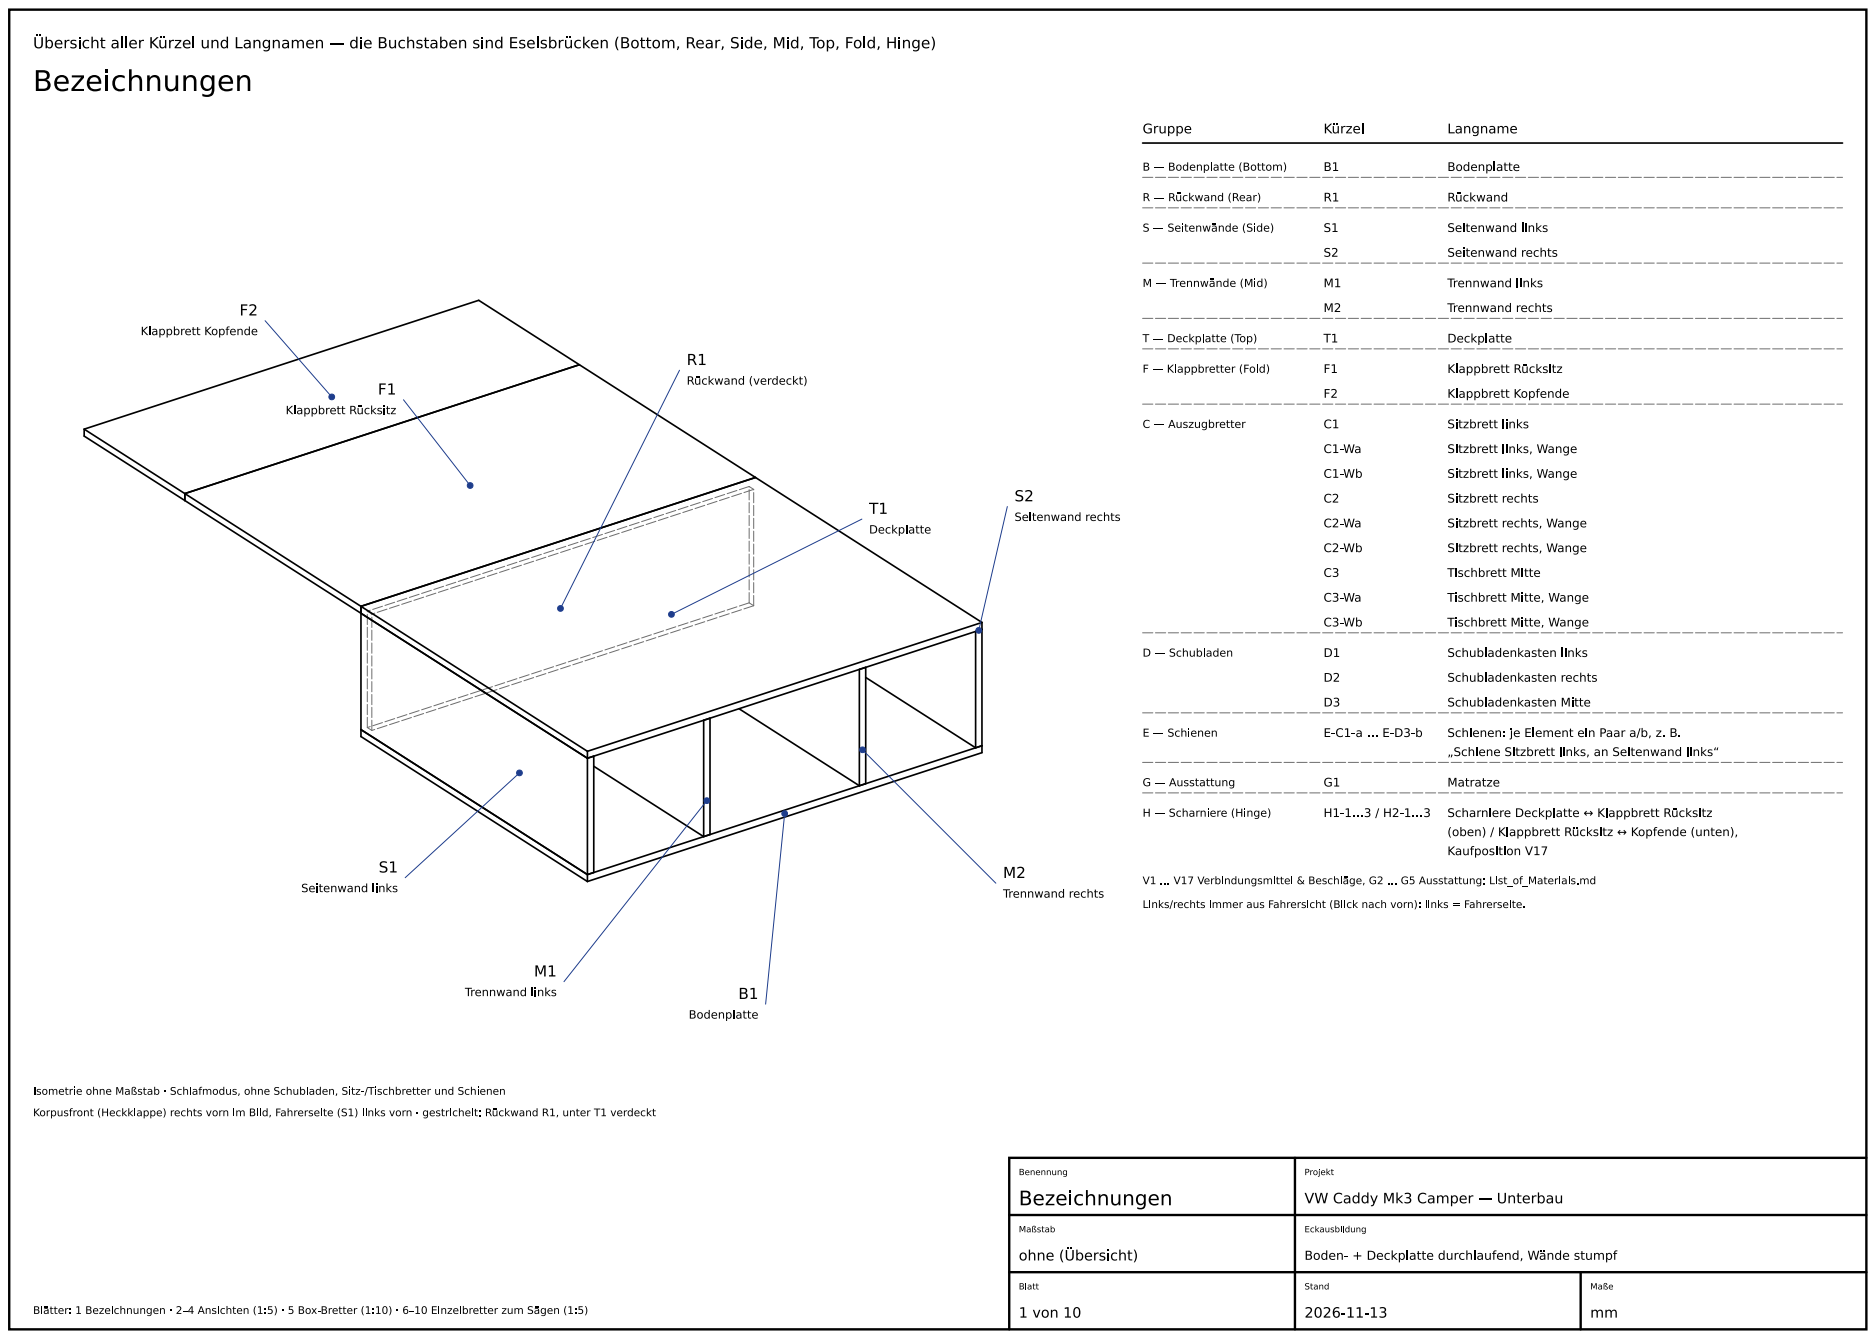
[picture p39: page 1]

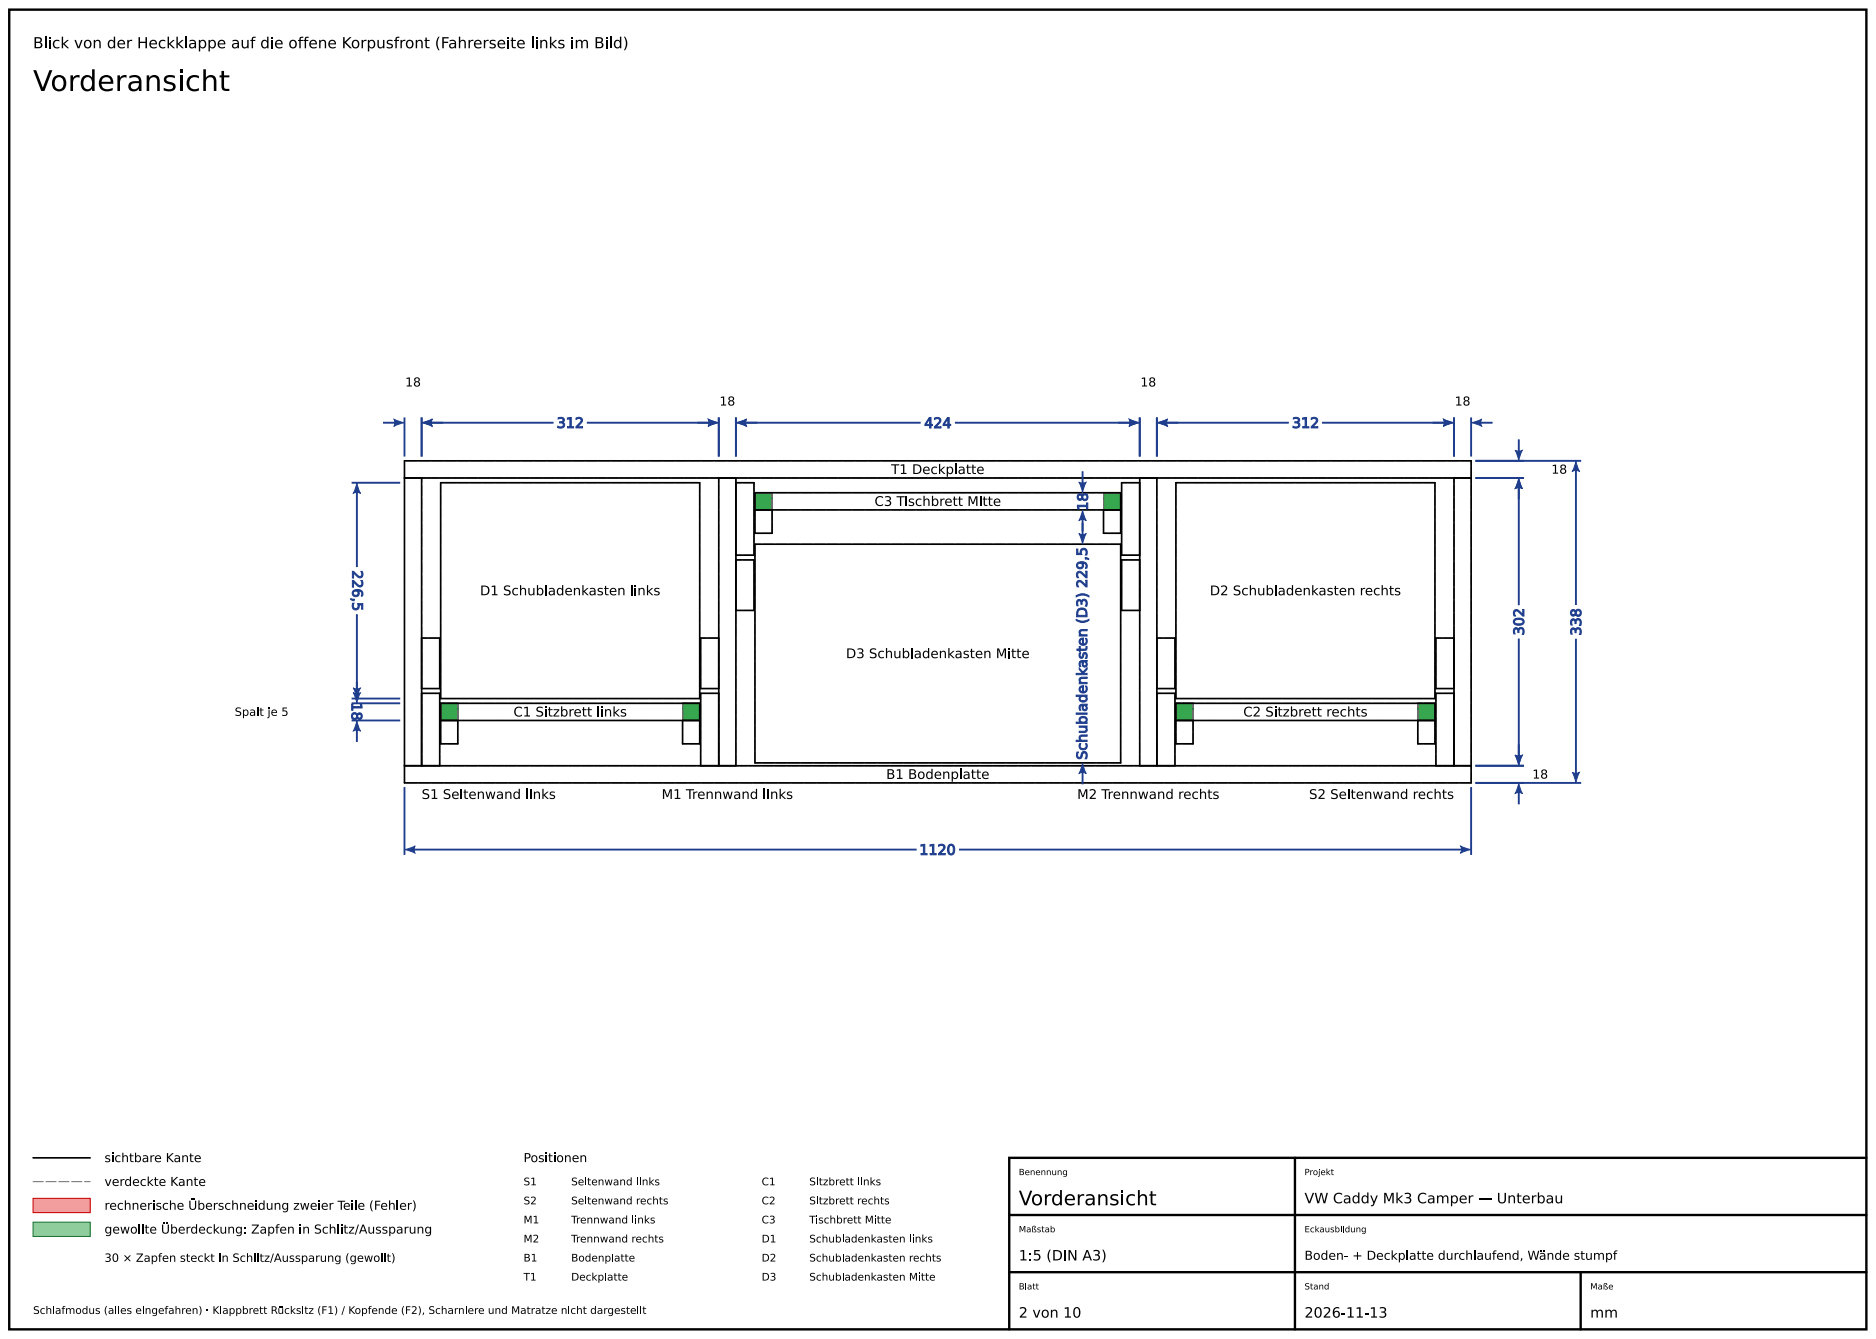
[picture p40: page 2]

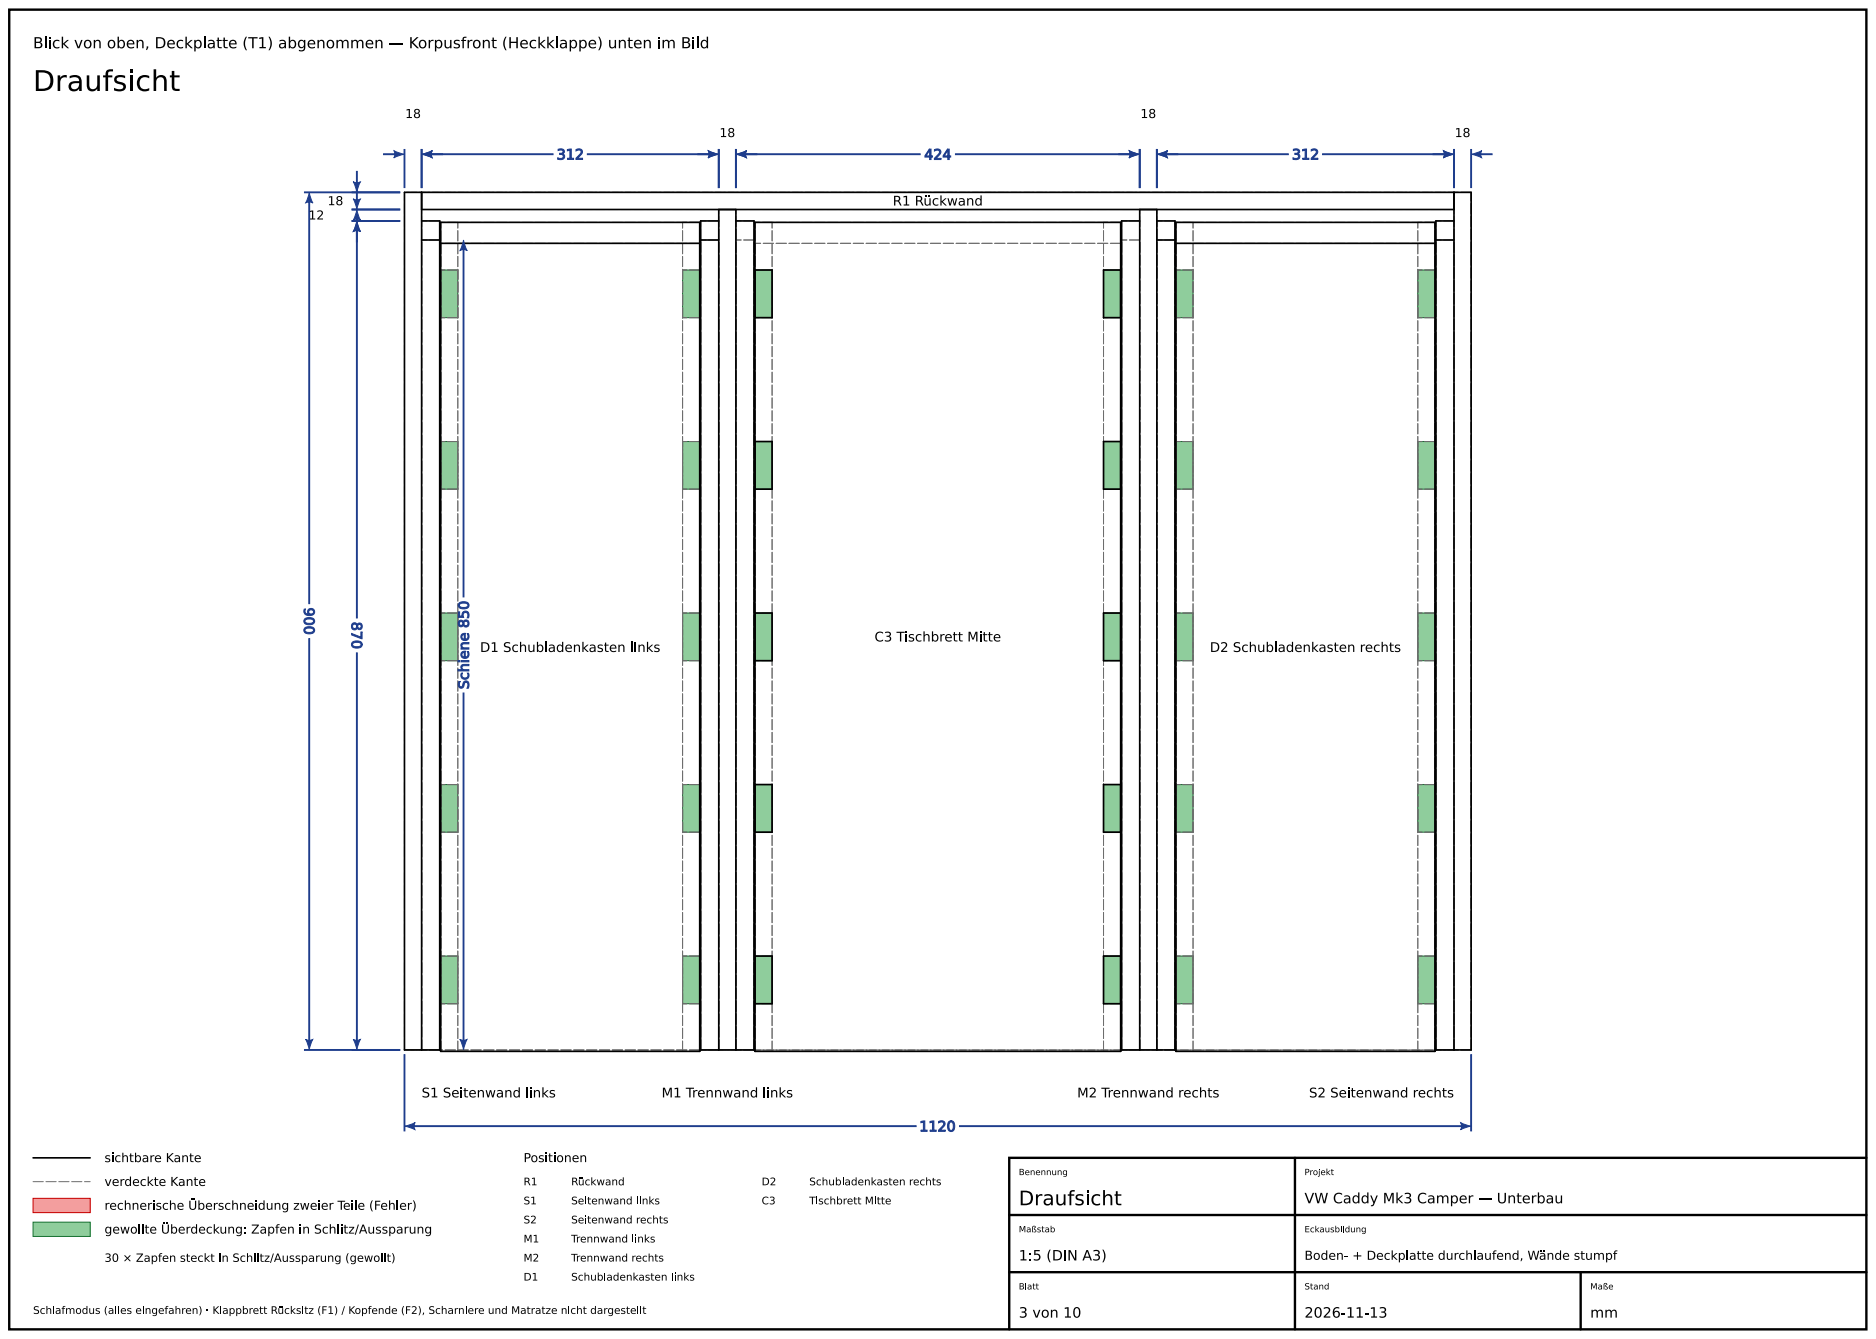
[picture p41: page 3]

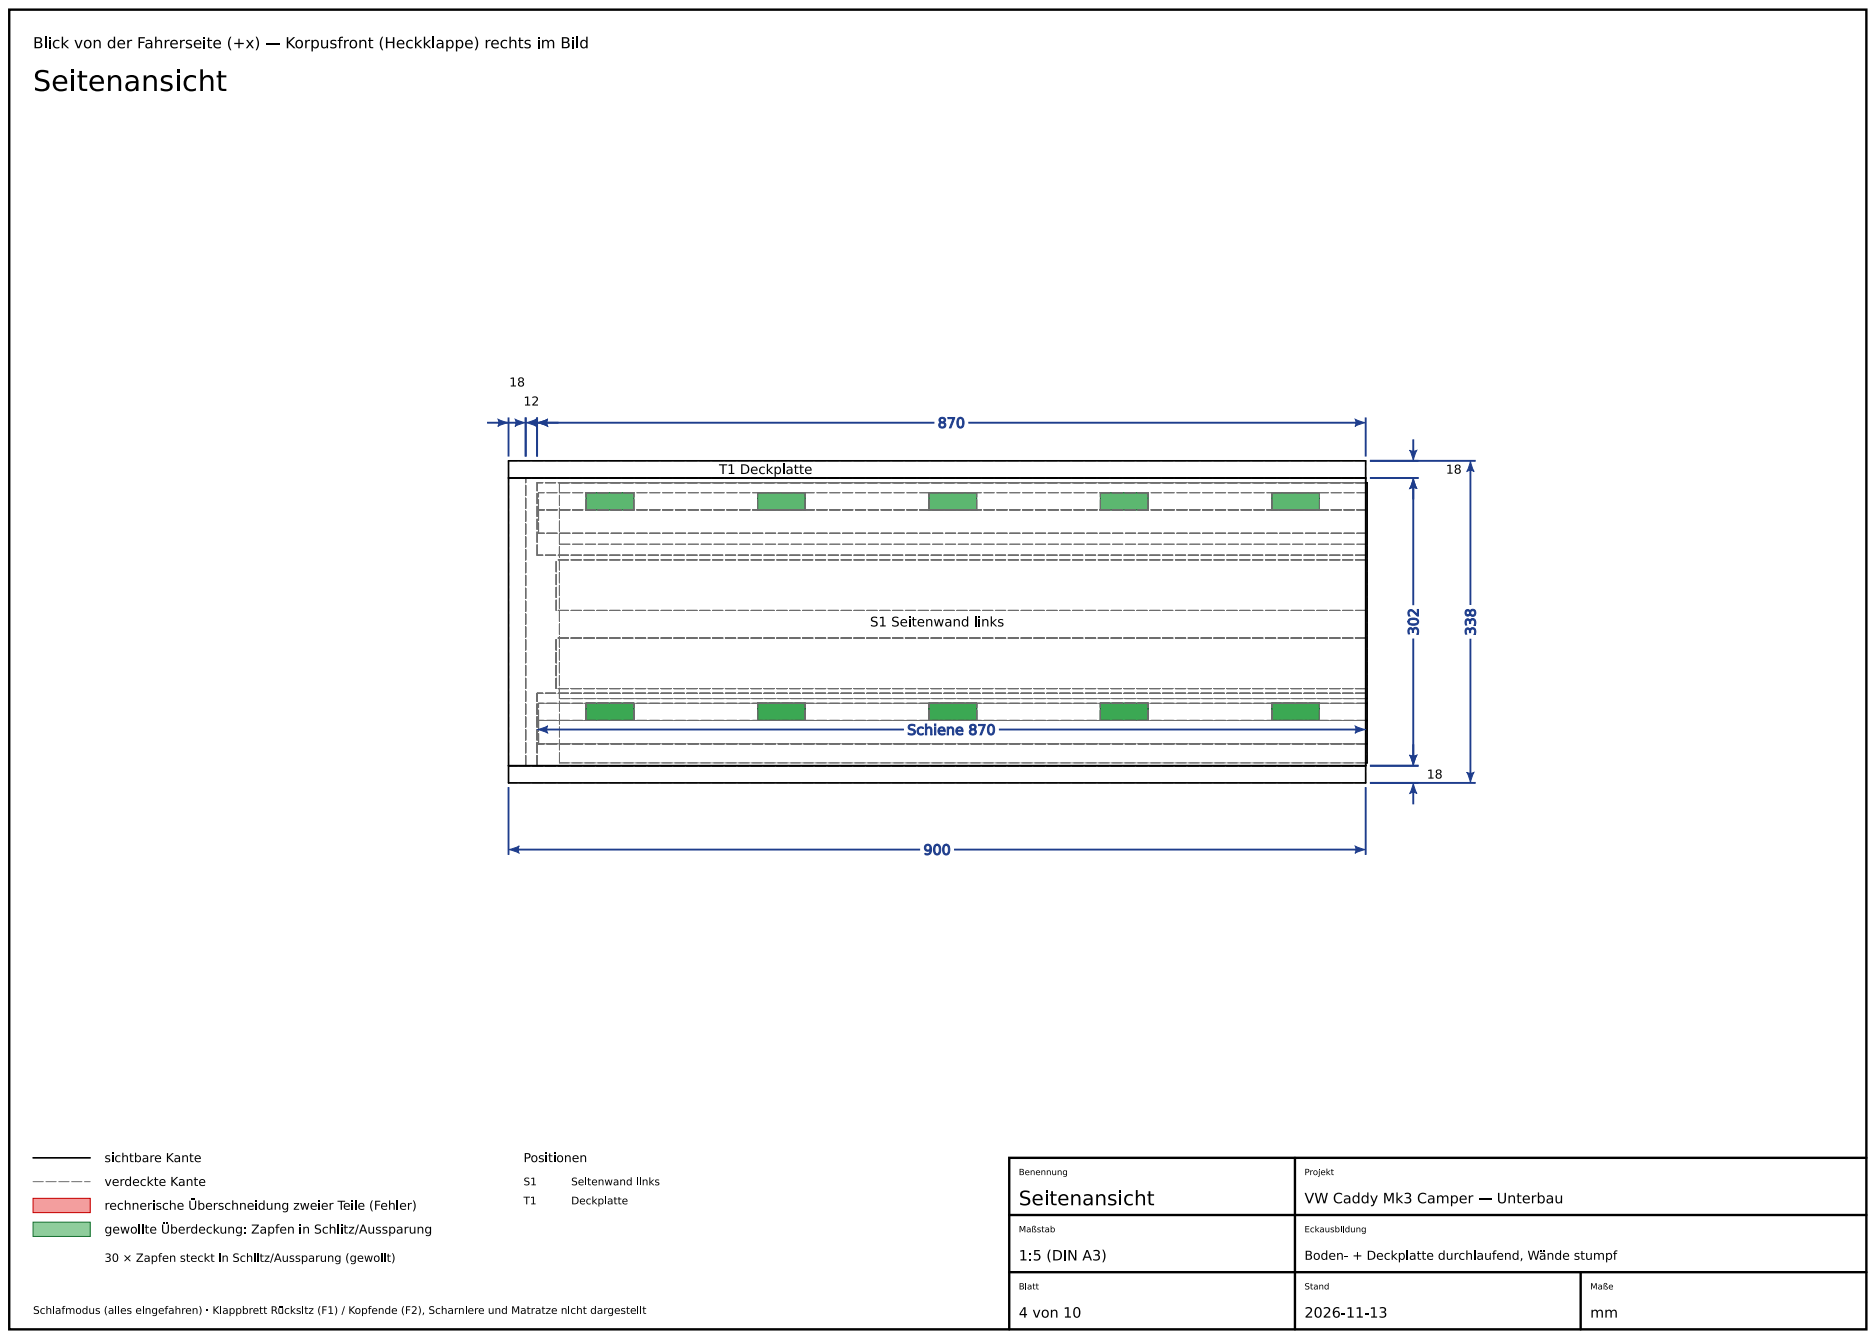
[picture p42: page 4]

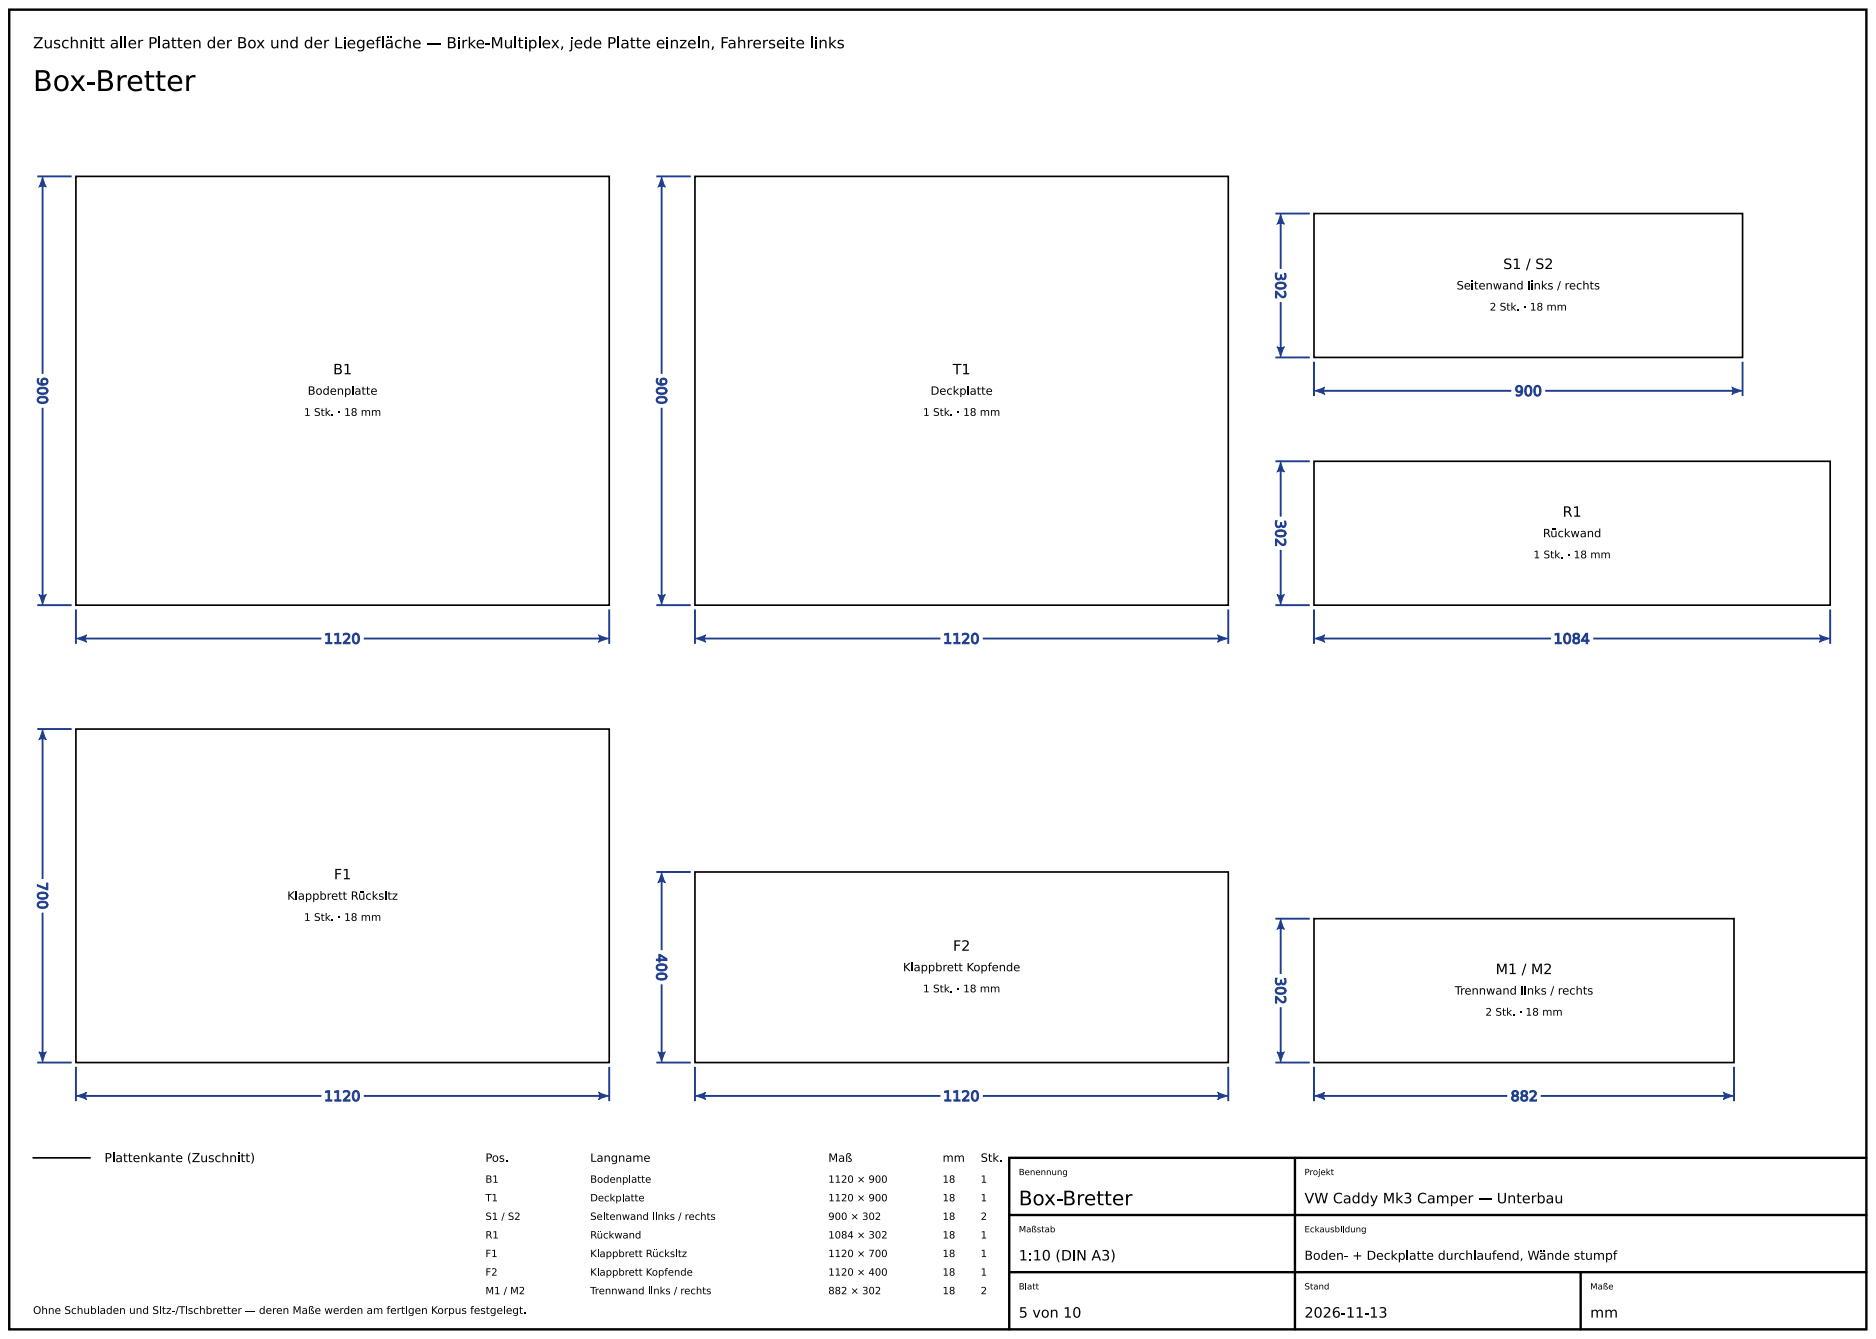
[picture p43: page 5]

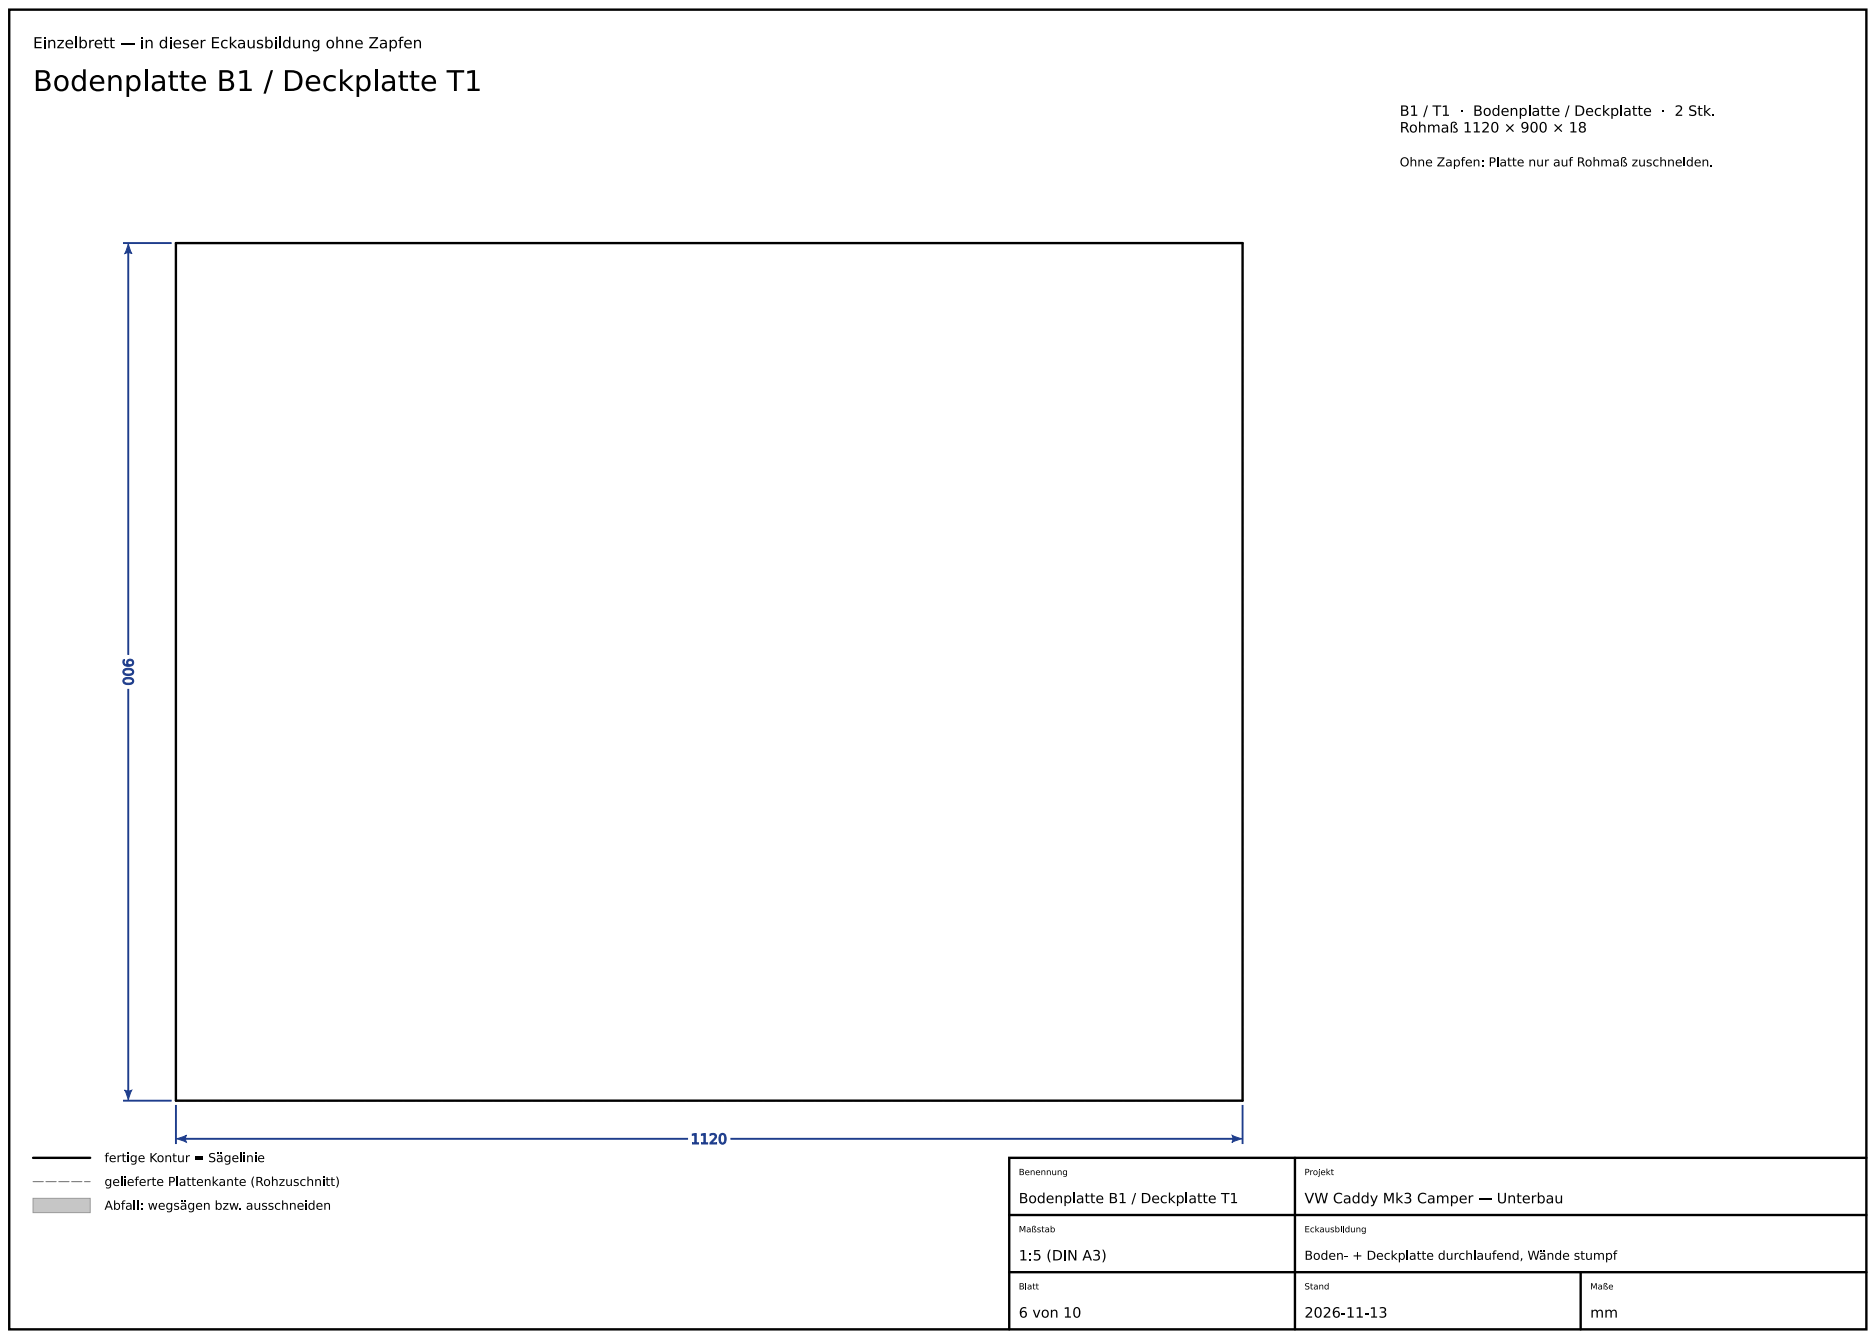
[picture p44: page 6]

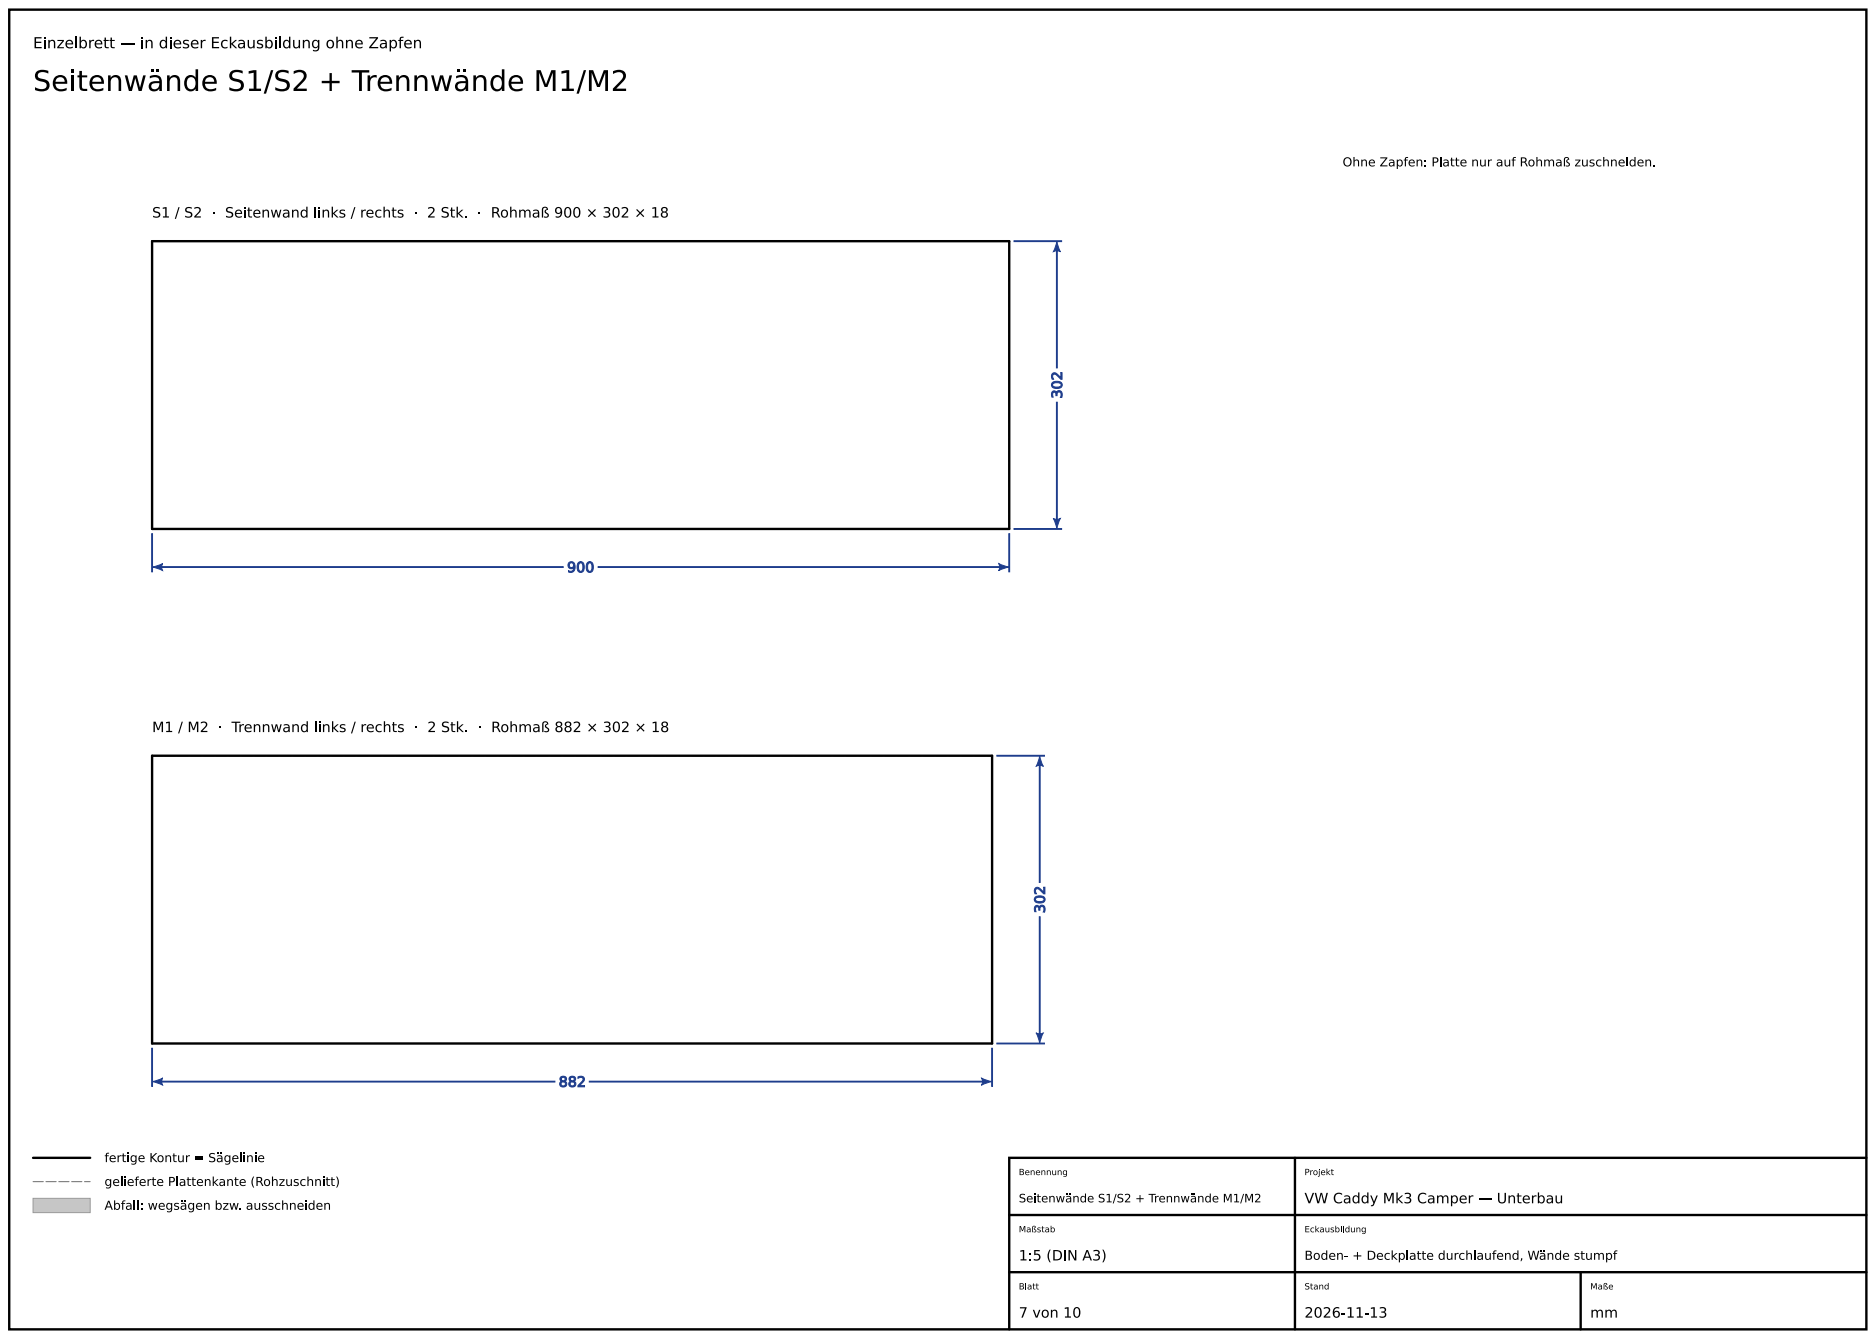
[picture p45: page 7]

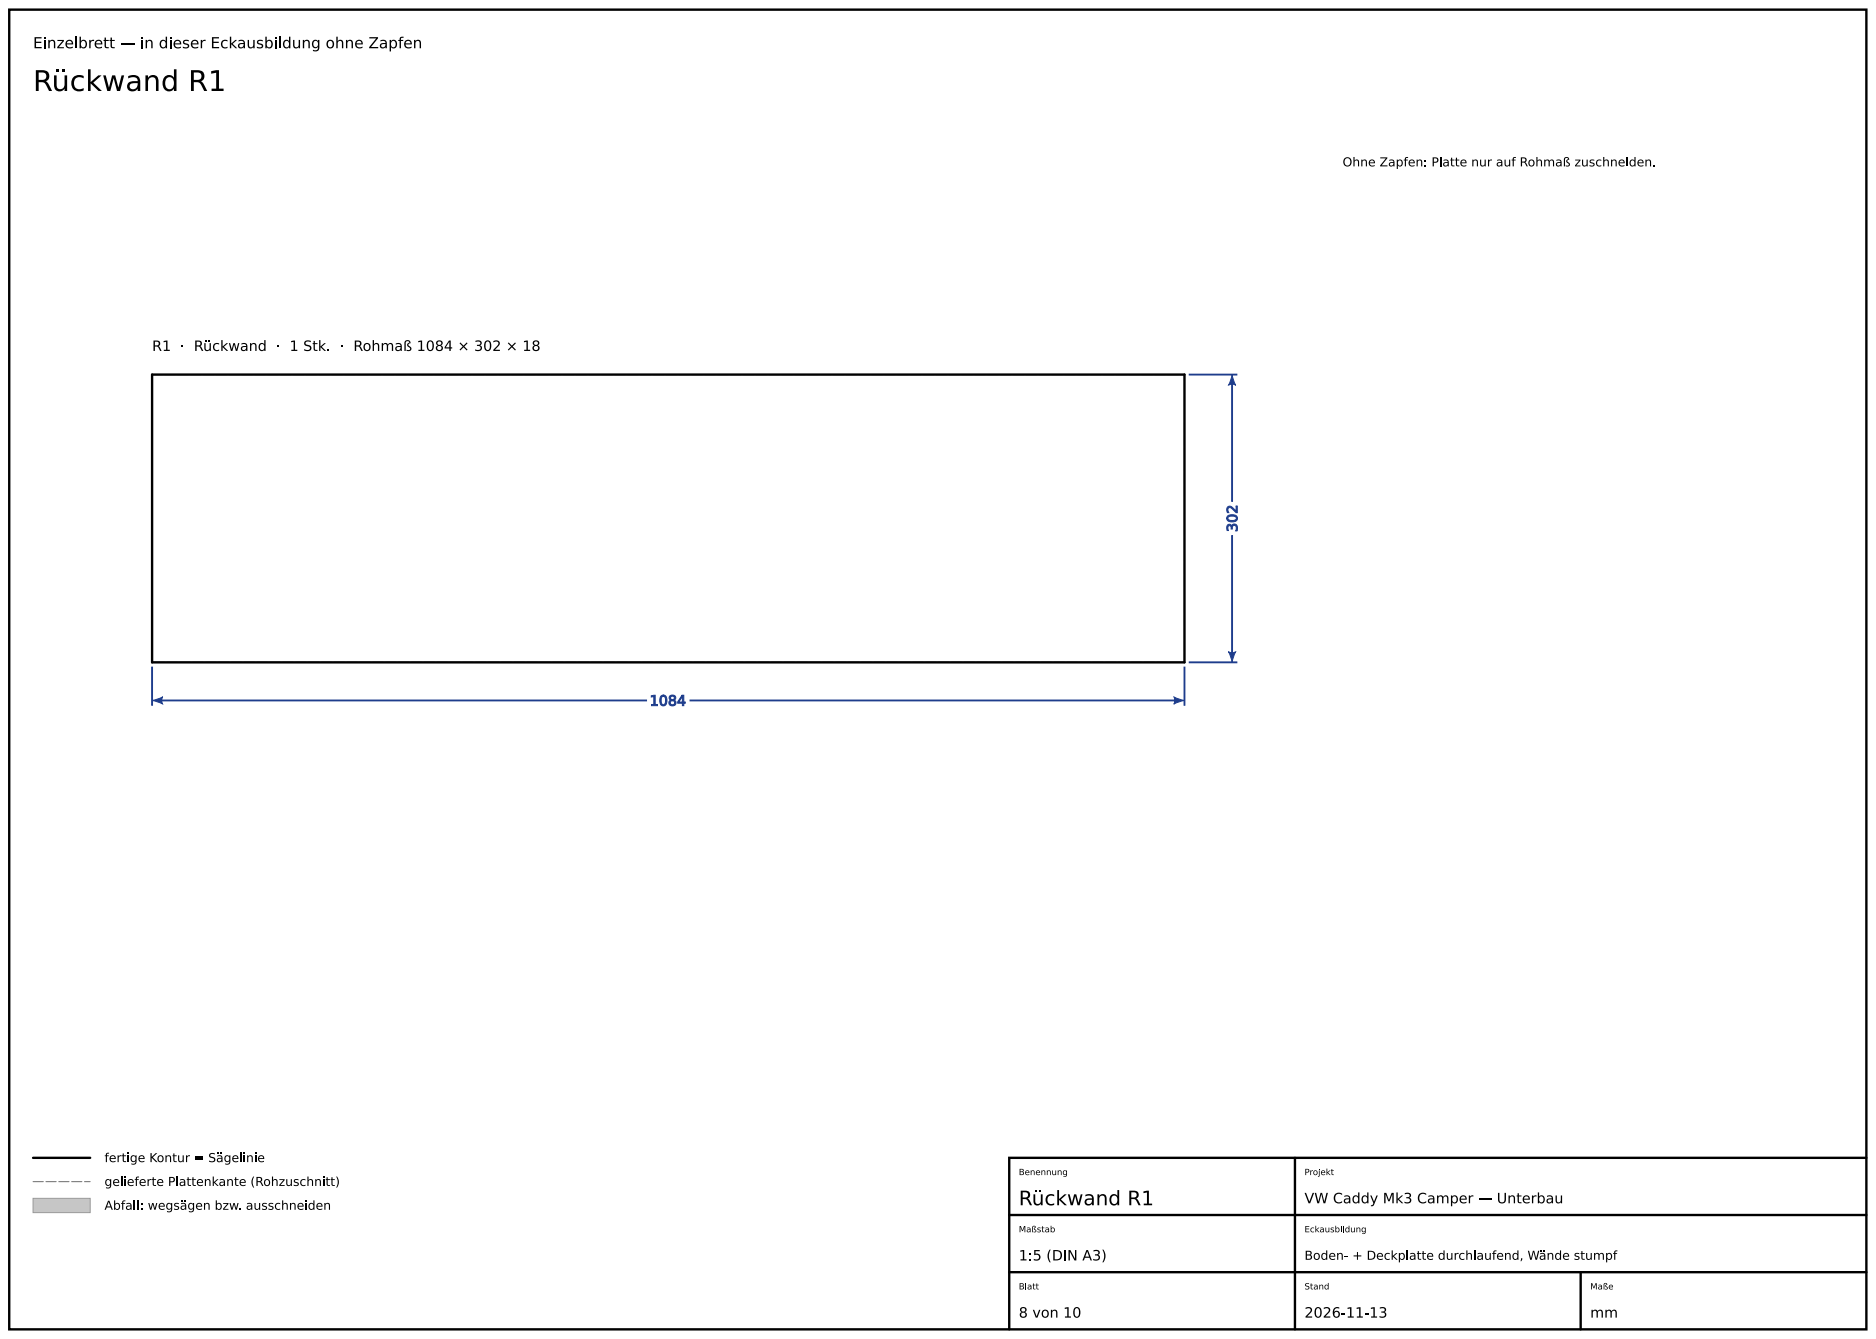
[picture p46: page 8]


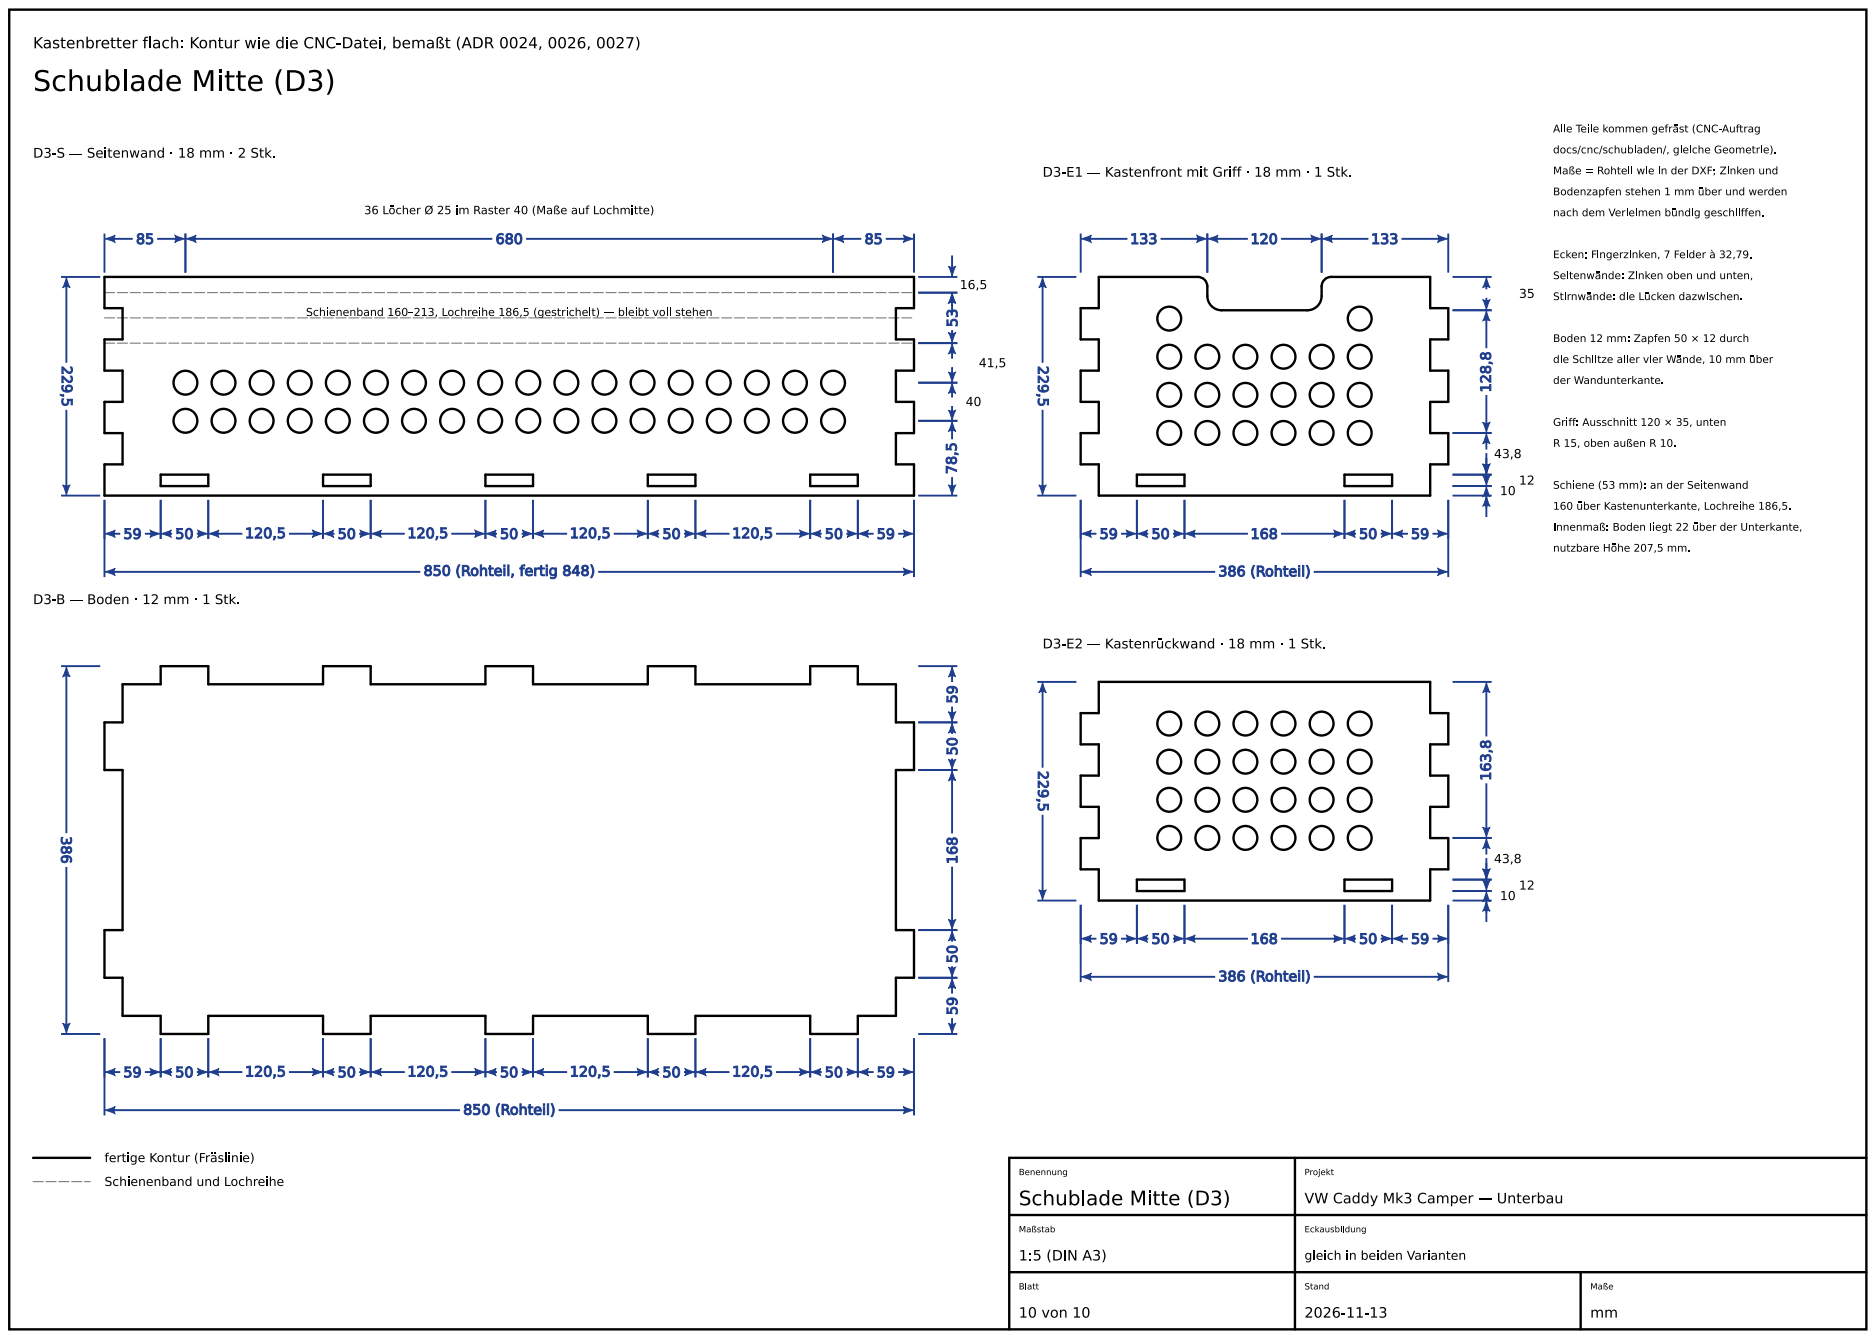
[picture p47: page 10]
