dbraun1991/Caddy-Camper-Construction/(commit log)

2026-09-03 Add AGENTS.md and ADRs documenting viewer and build decisions
    Adds AGENTS.md as an entry point for agents/contributors, including a
    Features & Future Work section, and docs/adrs/ with 8 records capturing
    decisions evident in the code and materials list: single-file no-build
    architecture, pinned Three.js version, the mm scale factor, the static
    scene-graph mode-switching approach, the simplified rail rendering, the
    three-section corpus layout, the joinery method, and the runner hardware
    selection.
    Claude-Session: https://claude.ai/code/session_01G1NnKK6p9ruaMWJsVCnxdz
2026-09-03 Link ADRs from the code and docs they document
    Adds short pointers from index.html, README.md, and List_of_Materials.md
    back to the relevant docs/adrs/ record at each decision site (scale
    factor, scene-graph/mode switching, rail simplification, section layout,
    runner selection, joinery), so the code and the decision record stay
    traceable to each other.
    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
2026-09-03 Add viewer screenshots and reference them from the README
    Captures the three modes (Schlafmodus, Bankmodus, Packmodus) via a
    headless browse of index.html served locally, stored under docs/pics/.
    Also corrects a stale README line describing the rail inner-members as
    toggled "lines" — they're always-present red boxes (ADR 0005) that are
    simply hidden inside the closed corpus until extended.
    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
2026-09-20 Fix mobile viewer: pinch-zoom and controls above system navigation
    Use dvh + safe-area inset so the buttons clear the phone navigation bar,
    add two-finger pinch-zoom with touch-action: none, and let the controls wrap.
2026-09-20 Add toggleable translucent Caddy shell view
    New caddyG group (60% opacity, open rear) toggled by a 'Caddy-Hülle' button,
    independent of the modes. Documents the decision in ADR 0009 and updates
    README and AGENTS.md.
2026-09-20 Default view: mirror rear camera to the other side
2026-09-20 Make Caddy shell more precise: door openings, rear-seat toggle, load-floor plane
    Side walls now have sliding- and front-door holes, cabin and front seats are
    modelled, the rear bench can be shown flipped flat or removed, and a load-floor
    reference plane marks y = 0 in the trunk. Documented in ADR 0010.
2026-09-20 Use documented usable width (1,120 mm) between wheel arches
2026-10-17 Plan the remaining build junctions and add a costed shopping list
    ADR 0007 and List_of_Materials.md §H covered the corpus shell only — the
    lid-to-vertical joint, the dividers and the back wall. Everything else that
    has to be held together was undocumented: the drawer boxes, the front
    panels, how the runners attach to the walls, the sleeping-platform board
    joints, and how the unit is secured in the vehicle.
    - ADR 0009: drawer boxes braced by their 12 mm bottom panel, mirroring the
    back-wall-as-shear-panel logic ADR 0007 already uses for the corpus.
    - ADR 0010: tie-down through the four factory lashing eyes only, no new
    holes in the body — keeps the module removable like ADR 0007 int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
2026-10-17 Document summer-use considerations beyond the physical build
    The user asked generically about sleeping in the car, scoped to summer-only
    use (so standheizung and breath-moisture/condensation are explicitly out of
    scope — those are cold/long-term-use problems, not summer ones) and noted
    the Caddy is still an unmodified series vehicle: no tint, curtains, roof
    vent, insect screens, or seat/headrest changes beyond this build.
    New Hinweise-Sommernutzung.md covers:
    - Legal: resting vs. camping under German traffic law — directly relevant
    here because Bankmodus extends the seat/table boards out the open
    tailgate, which is visually the camping gesture courts look for; flagged
    as stellpla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
2026-10-17 Correct the scope boundary around closed-window sleeping: CO2 is not seasonal
    The previous version lumped "Feuchtigkeitsmanagement der Atemluft" (breath
    moisture) in with Standheizung as a winter-only concern to defer. That
    conflated two different things under one label: condensation/mould (settling
    on cold surfaces — genuinely a cold-weather problem, correctly deferred) and
    CO2 buildup / fresh-air depletion from two people breathing in a closed
    cabin overnight — which is driven by respiration and cabin volume, not
    outside temperature, and was wrongly deferred along with it.
    - Hinweise-Sommernutzung.md §3 reworked: now states the overnight CO2 math
    (~25-30 l/h for two sleeping adults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
2026-10-17 Renumber build ADRs 0009–0011 to 0011–0013 after rebase
    origin/main had already taken 0009 and 0010 for the Caddy shell ADRs, so
    the drawer-box, tie-down and carrier-cheek ADRs move to 0011, 0012 and
    0013. All links and bare references are updated.
2026-10-17 Record the decision to keep side walls B2 and the corpus removable
    All rails are fastened to the corpus's own wood, so the complete module
    comes out of the car by undoing the lashing-eye tie-down. ADR 0014 closes
    the open "ggf. entfällt" note on B2 in the materials list.
2026-10-17 Record vehicle measurements and update the plan accordingly
    Measured on the car: 1,120 mm between the wheel arches (no play), the
    finished box fits through the tailgate, no load sill, 920-930 mm load
    depth, flat floor, folded rear seat backs at 310 mm, 2,000 mm to the
    headrests, rear lashing eyes beside the corpus.
    - modell/parameter.json gets a measured "fahrzeug" block; modell.py
    checks the plan against it and the "Statisch" tab shows the result
    - viewer: load width and seat-back height from the measurements,
    tailgate shown permanently open
    - A2 needs a 10 mm shim on the seat backs; A3 hangs from the headrests on
    two adjustable loops instead of a cross batten (F13 3 m -> 2 m, new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
2026-10-17 Correct the measured load width: 1,130-1,140 mm, corpus stays 1,120
    The previous commit recorded 1,120 mm with no play. The space between the
    wheel arches is 10-20 mm wider; the corpus deliberately stays at
    1,120 mm and does not use it.
2026-10-17 Use 850 mm runners and keep the corpus at 900 mm (ADR 0017)
    The 18 mm back wall leaves 882 mm of clear depth, so 900 mm runners never
    fitted. The corpus stays 900 mm deep (20-30 mm air to the rear seats);
    runners become 850 mm (AOLISHENG 850 mm / 170 kg for the drawers), drawer
    boxes 830 mm and seat/table boards 850 mm, leaving 32 mm behind them.
    All 18 back-wall overlaps disappear from the model and drawings.
    Drawings now dimension the runner end in the depth chains, and short chain
    segments get their number staggered outside the dimension line. The board
    runner model and the 850 mm runner's thickness (19 mm assumed) are still
    to be confirmed.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
2026-10-17 Use the AOLISHENG 850 mm runner at all six positions
    The separate 95 kg / 53 mm board runner (only found in 900 mm) is dropped;
    drawers and seat/table boards all run on the same 850 mm / 170 kg / 76 mm
    runner. Shopping list: 6 pairs at 104.99 EUR, budget recalculated
    (realistic ~1,650 EUR). ADR 0013 notes that its recommendation was made for
    the 53 mm runner and must be re-evaluated for 76 mm; the runner purchase is
    no longer blocked by it, only cutting C1-C3.
2026-10-17 Split runners: 170 kg for the seat boards, 80 kg for drawers and table
    Corrects the previous commit. The seat boards C1/C2 keep the AOLISHENG
    850 mm / 170 kg / 76 mm runner (2 pairs); drawers D1-D3 and the table board
    C3 get the AOLISHENG 850 mm / 80 kg / 53 mm runner (4 pairs, 61.99 EUR).
    The model now has runner types and a per-element assignment in
    parameter.json; rail bands and element widths are derived per type
    (seat L/R 18-94, drawer L/R ~202-255, drawer M ~78-131, table M 262-315 mm,
    no overlap on the dividers). Runners ~458 EUR, realistic total back to
    ~1,500 EUR. ADR 0013's update note distinguishes C1/C2 (76 mm) from C3
    (53 mm).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
2026-10-17 Decide the corner construction: continuous bottom and lid, walls in grooves
    B4 and A1 run through at 1,120 x 900 mm; all walls stand between them and
    are housed 6 mm deep (rebate along the outer edges, groove for the
    dividers). Cut sizes: B2 900 x 314, B1 1,084 x 314, B3 882 x 314.
    The model replaces the three exploratory corner variants with "genutet"
    and the fallback "stumpf", marks wall-in-recess overlaps as intended
    (green in the drawings, excluded from the problem count), and hides the
    back-wall rebate in the front view where it would look like a full-width
    groove. Drawings dimension the wall height (314) and groove depth.
    ADR 0018 amends ADR 0007: the recess replaces the dowels; the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
2026-10-17 Name left/right as seen from the driver's seat
    Section L (C1, D1) and Trennwand 1 now sit on the driver side (+x),
    R (C2, D2) and Trennwand 2 on the passenger side; previously L was on the
    passenger side. Geometry is unchanged because both outer sections are the
    same width. The convention is recorded in AGENTS.md and the materials list.
    Mattress, payload check, 12 V and ventilation are moved to a "deliberately
    left open" block in the README and AGENTS.md at the user's request.
2026-10-17 Allow 6-9 mm groove depth and cut the walls after routing
    Walls are cut to 302 + 2 x measured groove depth after routing. Depth is
    capped at about half the board: the recesses run the full depth, so a
    through-cut would remove the edge of B4/A1 or split the board.
2026-10-17 Hinge the sleeping boards and add two driving modes
    A2 is hinged to A1 on top and A3 to A2 underneath (3 standard folding
    hinges per joint). That hinge placement lets both fold back onto the box as
    a stack: A2 upside down on A1 (z 200-900), A3 on A2 (z 200-600), 386 mm
    high, with ~6 mm between boards from the hinge leaves.
    The hinges and their fold axes live in the shared model; the viewer puts
    A2/A3 into pivot groups and gains Fahrmodus 1 (boards folded, mattress
    stowed) and Fahrmodus 2 (also rear seats upright, 5 seats), plus a third
    rear-seat state. The overlap battens F13 are dropped (they would block the
    fold); hinges F17 are added and the budget recalculated. ADR 0019 amends
    ADR 0004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
2026-10-17 Pair every part code with a descriptive long name
    Codes stay as stable position numbers; the letter names the group
    (A Liegefläche, B Korpus, C Auszugbretter, D Schubladen, E Schienen,
    F Befestigung, G Ausstattung, S Scharniere) and each part gets a long name
    by function and position, left/right as seen from the driver:
    A1 Deckplatte, A2 Klappbrett Rücksitz, A3 Klappbrett Kopfende, B3-1
    Trennwand links, D1-F Schubladenfront links, rails e.g. "Schiene
    Sitzbrett links, an Seitenwand links", and so on.
    The long names live in the model (GRUPPEN/ELEMENTE) and therefore appear in
    the viewer's check report and in a new position list on every drawing
    sheet. List_of_Materials.md gets a "Bezeichnun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
2026-10-17 Rename the floor plate to F1 and fasteners to V1-V17
    Board groups now follow orientation: A horizontal on top (sleeping
    surface), B vertical (all walls), F horizontal at the bottom (F1
    Bodenplatte, formerly B4). Because F was taken by the fastener positions,
    those move to V1-V17 ("Verbindungsmittel & Beschläge").
    Renamed across the model, viewer, drawings, all docs and the ADRs (noted in
    docs/adrs/README.md). The registration field "F.1" and the drawer-front
    suffix "-F" are deliberately untouched.
2026-10-17 Add a "Box-Bretter" cutting sheet to the static drawings
    A fourth A3 sheet at 1:10 lays every board of the box and the sleeping
    surface out flat (F1, A1, A2, A3, B1, B2-F/B2-B, B3-1/B3-2), each with its
    dimensions, long name, quantity and thickness, plus a cut list. The
    rebates and grooves to be routed into F1 (top) and A1 (underside) are drawn
    dashed from the walls that sit in them. Generated from the same model per
    corner variant (walls 314 vs. 302 mm), selectable in the viewer's static
    tab; the other sheets now read "von 4".
2026-11-04 Replace routed grooves with through tenons
    The builder has no matching router bit, only a circular saw and a jigsaw,
    so the walls now join F1, A1 and B1 with 18 x 50 mm tenons (ADR 0020).
    Wall cut height is 340 mm and B3 is cut to 900 mm including its rear tenon,
    which makes the store cut list final. B1 gets four tenons per edge so none
    sits under the hinges on A1.
    The genutet variant and its drawings are removed; stumpf stays as fallback.
2026-11-04 Note the gap between table board C3 and lid A1
    Standing on A1 can bring it down onto C3 at the front edge, so runners
    should only be moved with no load on the lid.
2026-11-06 Put table board C3 on 170 kg runners and add a legend toggle
    C3 must take a person sitting on it, so it moves from the 80 kg / 53 mm
    runner to the 170 kg / 76 mm one like C1/C2 (ADR 0021). The order of
    2026-11-04 (2 x 170 kg + 4 x 80 kg) needs one more 170 kg pair; one
    80 kg pair is surplus. Docs record the ordered runners, the 170 kg
    fitting dimensions, the new divider screw overlaps and the updated budget.
    The 3D tab gets a "Legende" button; the legend starts hidden on narrow
    screens, where it covered the scene.
2026-11-06 Add single-board drawings with every tenon, slot and notch dimensioned
    Three new A3 sheets at 1:5 (F1/A1, B2 + B3, B1) show each board as cut
    from the delivered blank: finished contour as the saw line, waste shaded,
    and dimension chains from the board edges for all tenons, slots and
    notches. Selectable in the "Statisch" tab; sheet 4 points to them.
2026-11-06 Add long part names next to board codes in the workshop drawings
    Every in-drawing label, dimension text, note and sheet title that names a
    board by its code (F1, A1, B3, ...) now also carries its long name from the
    part model; the sheet selector in the "Statisch" tab follows suit. Outer-wall
    labels are aligned inward and the A1 label in the side view is shifted so
    the longer texts don't cross extension lines or tenons.
2026-11-06 Rename board codes to mnemonics (Bottom, Rear, Side, Mid, Top, Fold)
    F1→B1 Bodenplatte, B1→R1 Rückwand, B2-F/B2-B→S1/S2 Seitenwände,
    B3-1/B3-2→M1/M2 Trennwände, A1→T1 Deckplatte, A2/A3→F1/F2 Klappbretter,
    model hinges S1-*/S2-*→H1-*/H2-*. Applied to the model, parameters,
    viewer, drawings (single-board sheets renamed to brett-b1-t1, brett-s-m,
    brett-r1), documents and, as with the 2026-10-17 renaming, the ADRs in
    place. ADR 0022 records the mapping and why D1 and a shared B1 were ruled
    out; the glossary lists each old code next to the new one.
2026-11-06 Add a "Bezeichnungen" overview sheet and a printable PDF of all sheets
    Sheet 1 now shows an isometric view of the box and sleeping platform
    with every board labelled (code + long name, R1 dashed under the lid)
    and a table of all part codes grouped by their mnemonic letter, generated
    from the model. The other sheets move up by one. Per corner variant, all
    eight sheets are merged into werkzeichnungen.pdf (A3 landscape, vector,
    via cairosvg + pypdf) for printing at 100 %. The viewer lists the new
    sheet first and links the PDF.
2026-11-07 Add a DXF export for a CNC routing service
    modell/cnc.py writes one 2D DXF per distinct board (b1-t1, s1-s2, m1-m2,
    r1, f1, f2), an unnested overview of all nine parts and an AUFTRAG.md
    with the parts list and every assumption, per corner variant under
    docs/cnc/. Outer profile and closed slots on separate layers, lines and
    arcs only, no drill holes. Every concave corner gets a dogbone sized to
    the cutter, slots and notches get fit clearance; both come from the new
    `cnc` block in parameter.json and are marked as assumptions (cutter
    6 mm, clearance 0.2 mm) until a service confirms them. Whether parts may
    be flipped during nesting is derived from each contour's symmetry.
    ADR 0023 records the ap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
2026-11-07 Add a "DXF · CNC" tab to the viewer
    The third tab shows a preview of every DXF (outer profile red, slots
    blue), part code, long name, quantity, size and a download link, the
    full-job overview, and all notes and assumptions for the CNC order.
    modell/cnc.py now builds those notes from one list (abschnitte()) that
    feeds both AUFTRAG.md and docs/cnc/cnc.js, so they cannot drift apart,
    and writes SVG previews next to the DXFs. cnc.js is loaded via
    <script src> so the tab also works from file://. The tab is linkable
    as index.html#cnc; hash handling now runs after all tabs are defined.
2026-11-07 Show mnemonic names (Bottom_1, Side_2, …) for the CNC parts
    The part titles in the "DXF · CNC" tab and in AUFTRAG.md now read e.g.
    "Bodenplatte (Bottom_1) und Deckplatte (Top_1)". The wording per board is
    a template in modell/cnc.py; the mnemonic word comes from modell.GRUPPEN
    and the number from the part code.
2026-11-07 Note myspiegel.de as a shipping option for plain panel cuts
    The panel-cut-only providers in Einkaufsliste.md §1 are now a table.
    myspiegel.de (Kassel) ships with its own vehicles (9,90 € in Germany,
    about 5–8 working days) or can be picked up; rectangles only, max.
    122 × 247 cm, birch multiplex 4–21 mm. Open: whether 18 mm is stocked
    and whether the quality fits ("zum Möbelbau nicht geeignet" per shop).
2026-11-12 Plan the drawer boxes as a CNC job with finger joints and lightening windows
    Drawer boxes D1–D3 are now 2D CNC parts (ADR 0024): finger-jointed corners,
    a 12 mm bottom with tabs through slots in all four walls, and four windows
    per side wall that keep the runner band solid. Board geometry comes from
    modell.schubladen_bretter() (parameters in parameter.json → schubladen);
    modell/cnc.py writes the separate job docs/cnc/schubladen/ and the viewer's
    CNC tab gains a "Schubladenkästen" option.
    ADR 0011's box joinery is superseded; V8 and V12 are dropped from the parts
    and shopping lists. Runner thickness measured on delivery: 19 mm for both
    types, as modelled, so the box widths stand. The 17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
2026-11-12 Interleave the drawer runners between the seat and table runners
    The drawer runner heights were a rule of thumb (2/3 and 1/3 of the box) and
    overlapped the seat/table runner bands across M1/M2 by 16 mm, where the M5
    through-bolts would land under a neighbouring runner. The model now places
    both drawer bands in the free strip between seat and table runners with equal
    clearance (D1/D2 107–160, D3 173–226; ADR 0025), so nothing overlaps.
    V9 shortened to M5 × 30 so bolt end and nut stay clear of the neighbouring
    element (20 mm from the wall). Drawings, viewer data and the drawer CNC job are
    regenerated; the lightening windows follow the runner bands.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
2026-11-12 Rework drawers and seat boards: no front panels, boards on cheeks, foolproof runner layout
    Drawer boxes (ADR 0026, 0027):
    - Large windows only in the outer drawers D1/D2 (reach in while seated); the
    middle drawer D3 and every box front/rear wall get a grid of Ø 25 mm holes.
    - No front panels: they would have blocked the 76 mm seat/table runners. The
    box front (-E1) is the visible front with a milled grip cut-out from the top;
    -E2 is the rear. D1-F…D3-F retired, handles V6 dropped. 13 → 0 overlaps.
    Height plan (ADR 0028, decides ADR 0013):
    - Seat/table element = 18 mm board on top of two cheeks; board top 1.5 mm above
    the runner so the runner never forms an edge. Cheeks end 20 m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
2026-11-12 Size cheeks to the 55 mm runner member, flush seat, through-tenoned cheeks, taller D3
    - Cheeks end 2 mm above the centred 55 mm telescope member (12.5 mm above the
    runner bottom), board top flush with the runner; element 63.5 mm high
    - Cheeks joined to the board by 5 through-tenons each plus glue, modelled as
    intended overlaps; fabrication of C1-C3 still open
    - D3 taller than D1/D2 (227.5 mm, capped 3 mm under the C3 cheeks), its runner
    kept 5 mm under the table runner; D1/D2 216 mm
    - Viewer: vehicle raised to the assumed 580 mm load-sill height with
    placeholder underbody and wheels
    - ADR 0029, BOM, README, AGENTS updated; drawings and drawer CNC job regenerated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
2026-11-12 Render runners as telescopes: housing, middle and inner member
    - Housing stays at the wall, the 55 mm middle member travels 430 mm, the
    30 mm inner member and lock lever travel with the element (measured on the
    170 kg runner; 80 kg values estimated)
    - Silver grey, darker further in; dimensions from schienen.typen.*
    - ADR 0030 supersedes ADR 0005; README and AGENTS updated
2026-11-12 Mill all four corners of the drawer grip cut-out
    The two top outer corners, where the cut-out meets the top edge, now get
    R 10 (griff.radius_oben) instead of being eased by hand; the bottom corners
    keep R 15. The 3D viewer draws the grip with the same radii.
2026-11-12 Darken the Caddy shell, record that all runners are ordered
    - Shell colour halved toward black (#2F0D1B, edges #4D2536)
    - 3 pairs 170 kg + 3 pairs 80 kg are ordered; lock holds when extended
2026-11-12 Lower seat and table boards flush with the 55 mm runner member, minimal cheeks
    - Board tops flush with the middle telescope member (10.5 mm below the
    runner top); nothing stands above seat or table outside the box
    - Cheeks end 15 mm below the hole line (24.5 mm, blank 43.5 mm with the
    through-tenons); tenon joinery kept for stability, the between-cheeks and
    30 mm-flush variants eliminated
    - D1/D2 226.5 mm, D3 229.5 mm (+15); drawer runners keep 5 mm to the board
    runner on the same wall face
    - Caddy shell a little darker
    - ADR 0031; BOM, README, AGENTS updated; drawings and drawer CNC job regenerated
2026-11-12 Add drawer workshop sheets, set load sill to 350 mm, lower front seats
    - Two A3 sheets at 1:5 (schublade-d1-d2, schublade-d3): every box board
    flat with the CNC contour, dimensioned (fingers, bottom slots/tabs,
    windows/holes, grip, runner band); in the Statisch tab and the PDF
    - fahrzeug.ladekante_hoehe 350 (assumption, not measured)
    - Front seat placeholders lowered by 200 mm
    - README, AGENTS, ADR 0024, BOM updated
2026-11-12 Record open ADR 0032: lightening the corpus boards
    Hole grid or windows in the already cut corpus boards: T1, F1/F2, M1/M2 stay
    solid, R1 hole grid at most (sole wall against lateral racking), S1/S2 and
    B1 either. Saves ~1.5-6.5 kg; only worth it if the tenon reliefs and slots
    are CNC-milled anyway. Not decided, model unchanged.
2026-11-12 Note TODOs: measure the bought hinges, re-check lightening F1/F2
    - Record the size of the V17 hinges already bought (model still assumes
    60 / 60 / 3 mm)
    - ADR 0032: F1/F2 carry almost no load (F1 rests on the folded rear seat
    backs, F2 hangs on loops); the "solid" assessment is to be re-checked
